aculleon/rpm_TSAL/3D/TBA_1-1219HI.stp

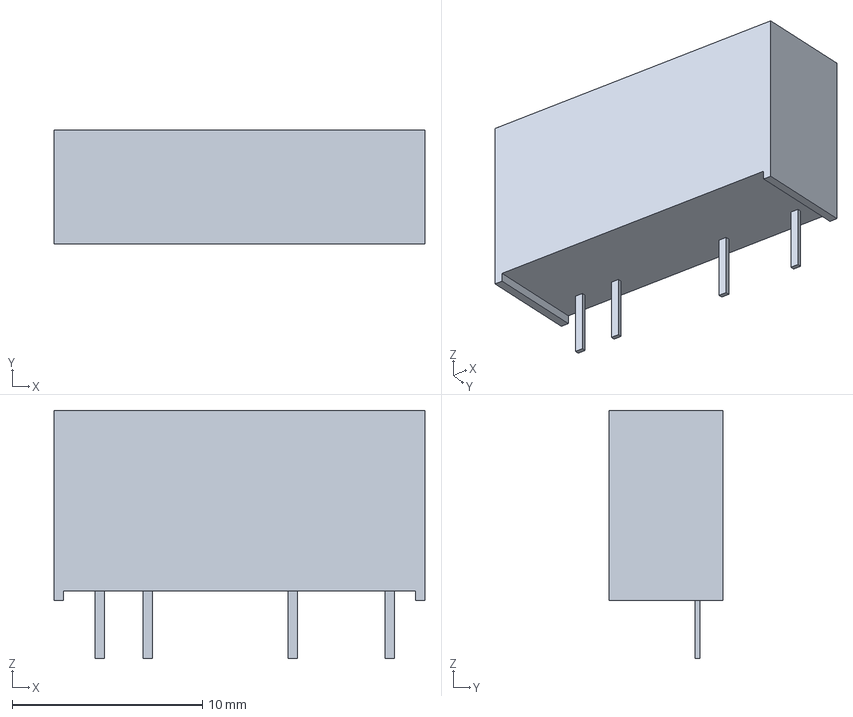
[picture p1: CAD file, 2024-07-24]
3D/TBA_1-1219HI.stp
19.5 x 6.00 x 13.1 mm
