aculleon/rpm_TSAL/rpm_TSAL.step

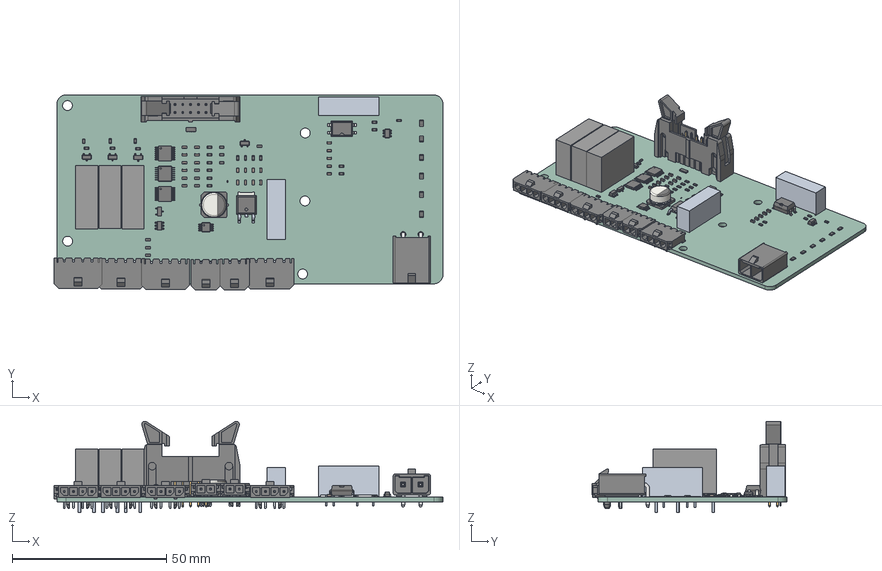
[picture p2: CAD file, 2024-07-24]
rpm_TSAL.step
126.2 x 63.3 x 29.7 mm
R_0603_1608Metric x 31
C_0603_1608Metric x 22
R_0805_2012Metric x 6
SOT_23_6 x 2
TSSOP_14_44x5mm_P065mm x 3
6620xx11022 x 4
SOT-23-3 x 5
6620xx11024 x 2
TBA1HI-SINGLE x 2
6120xx22021
CQ assembly x 2
Nexperia_HUSON-16_USON-16-1EP_1.35x3.3mm_P0.4mm_EP0.4x2.8mm
SMDIP_4_W953mm
6570xx130101
TSSOP_8_3x3mm_P065mm
CP_Elec_8x54
ASSEMBLY x 3
rpm_TSAL_PCB
