aculleon/rpm_TSAL/rpm_TSAL_RED/3D/AZ9371-1A-12D.stp

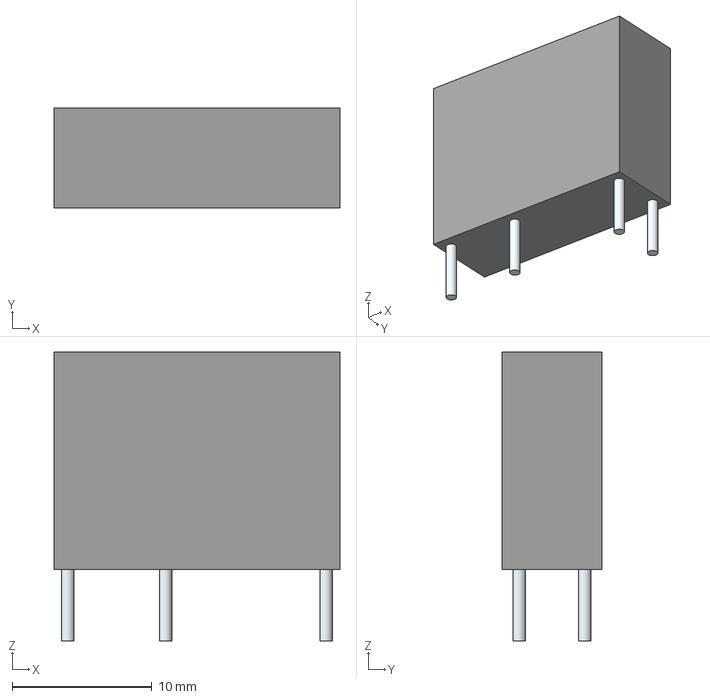
[picture p3: CAD file, 2024-07-11]
rpm_TSAL_RED/3D/AZ9371-1A-12D.stp
20.5 x 7.20 x 20.7 mm
Leads x 4
