aculleon/rpm_TSAL/rpm_TSAL_RED/3D/STP_MPC5_657002130101 (rev1).stp

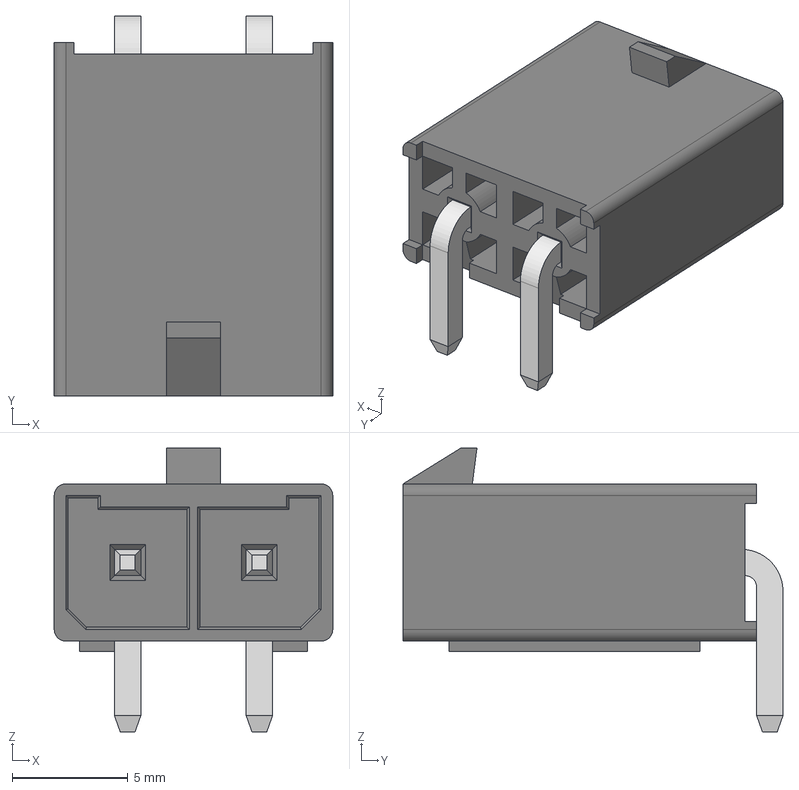
[picture p4: CAD file, 2024-07-11]
rpm_TSAL_RED/3D/STP_MPC5_657002130101 (rev1).stp
12.1 x 16.4 x 12.3 mm
6570xx130101_Pin x 2
