aculleon/rpm_TSAL/rpm_TSAL_RED/3D/66200411022 (rev1).stp

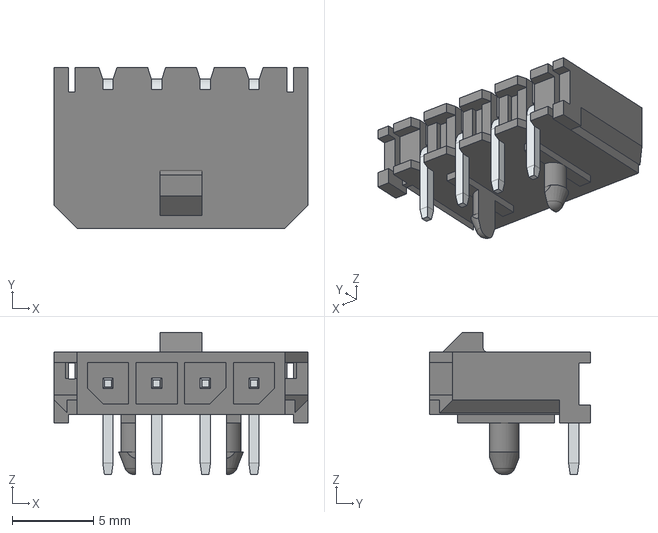
[picture p5: CAD file, 2024-07-11]
rpm_TSAL_RED/3D/66200411022 (rev1).stp
15.7 x 9.90 x 8.76 mm
6620xx11022_PIN x 4
