aculleon/rpm_TSAL/3D/66200421022 (rev1).stp

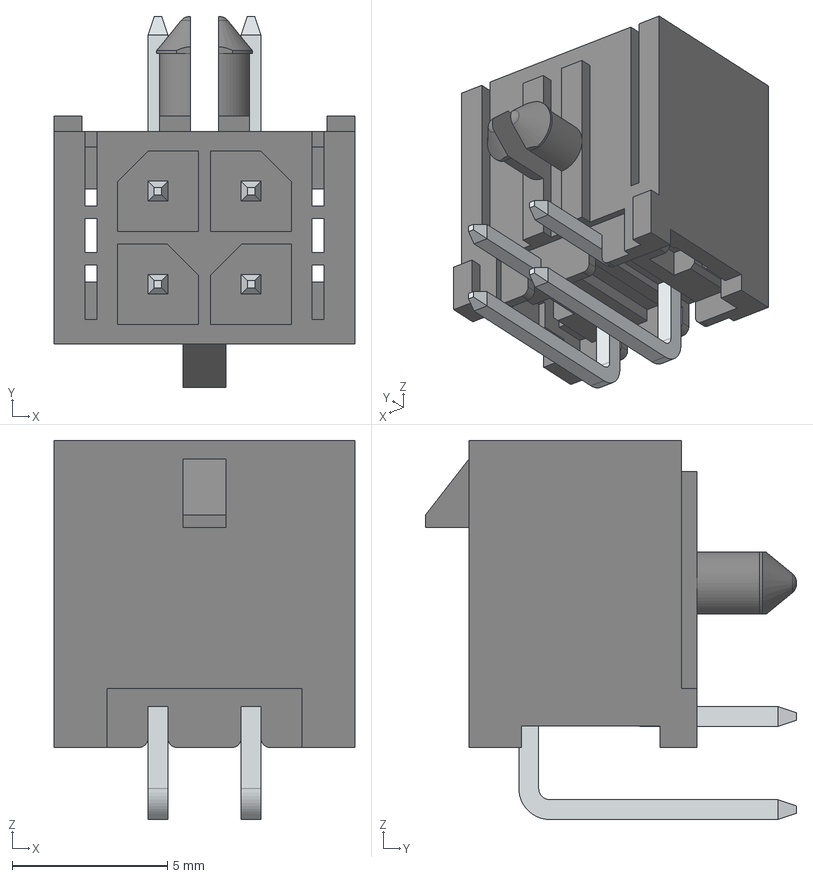
[picture p6: CAD file, 2024-07-24]
3D/66200421022 (rev1).stp
9.70 x 12.0 x 12.2 mm
6620xx21022_PIN_COURTE x 2
6620xx21022_PIN_LONGUE x 2
