aculleon/rpm_TSAL/3D/61201022021 (rev1).stp

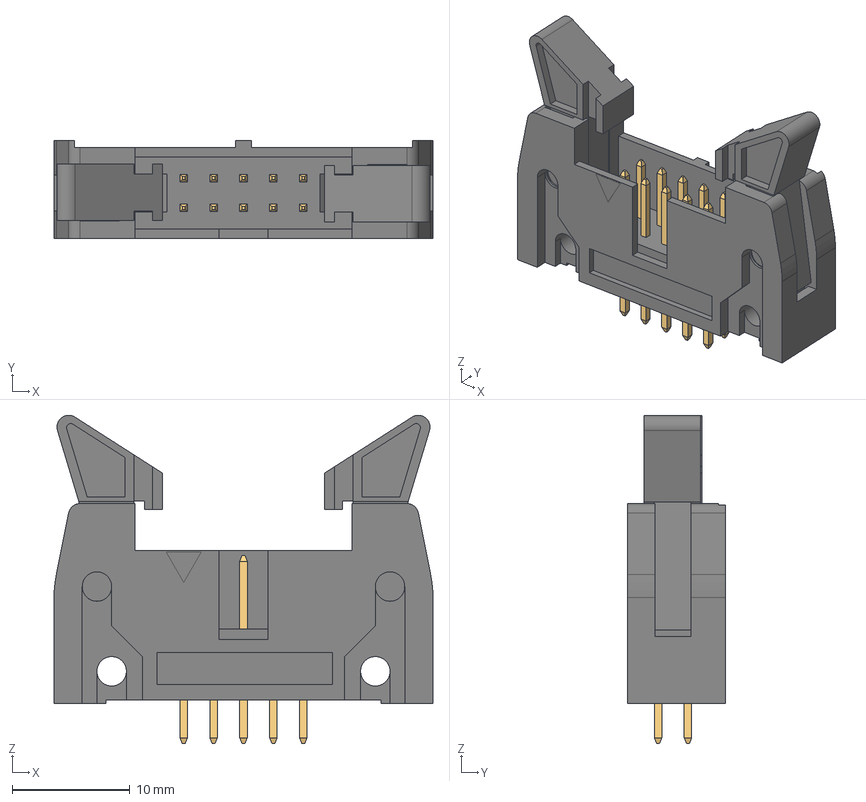
[picture p7: CAD file, 2024-07-24]
3D/61201022021 (rev1).stp
32.2 x 8.31 x 27.9 mm
6120xx22x21_LEVIER_COURT x 2
6120xx21621_PIN x 10
