aculleon/rpm_TSAL/rpm_TSAL_RED/3D/66201421022 (rev1).stp

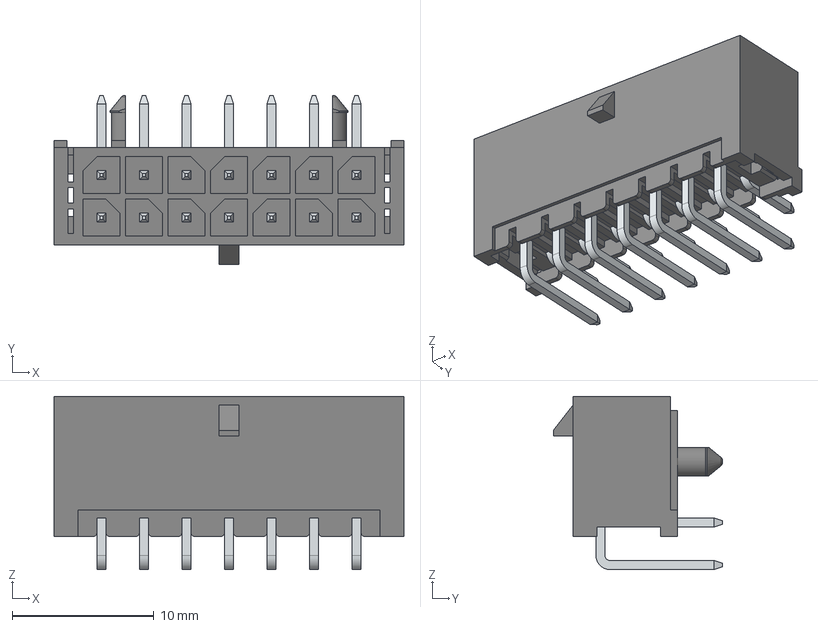
[picture p8: CAD file, 2024-07-11]
rpm_TSAL_RED/3D/66201421022 (rev1).stp
24.7 x 12.0 x 12.2 mm
6620xx21022_PIN_COURTE x 7
6620xx21022_PIN_LONGUE x 7
