aculleon/rpm_TSAL/rpm_TSAL_RED/3D/66200211024_STP (rev1).stp

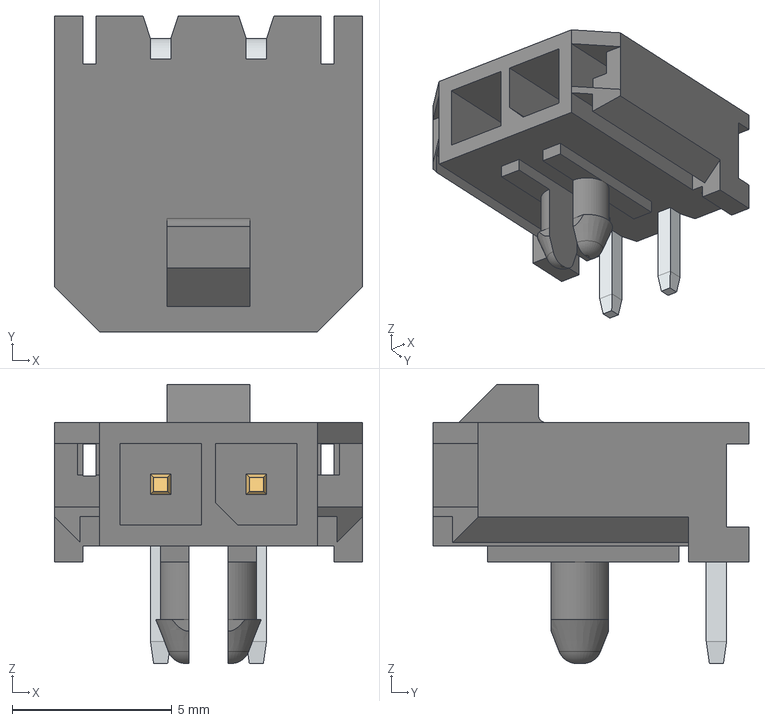
[picture p9: CAD file, 2024-07-11]
rpm_TSAL_RED/3D/66200211024_STP (rev1).stp
9.65 x 9.90 x 8.76 mm
6620xx11024_PIN x 2
