aculleon/rpm_TSAL/rpm_TSAL_RED/3D/66200311022 (rev1).stp

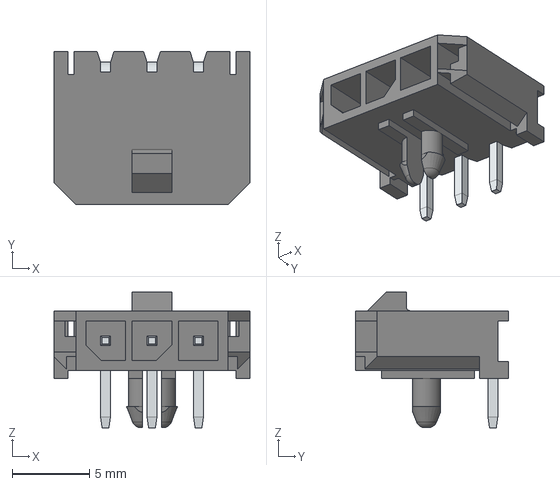
[picture p10: CAD file, 2024-07-11]
rpm_TSAL_RED/3D/66200311022 (rev1).stp
12.7 x 9.90 x 8.76 mm
6620xx11022_PIN x 3
