aculleon/rpm_TSAL/rpm_TSAL.pdf

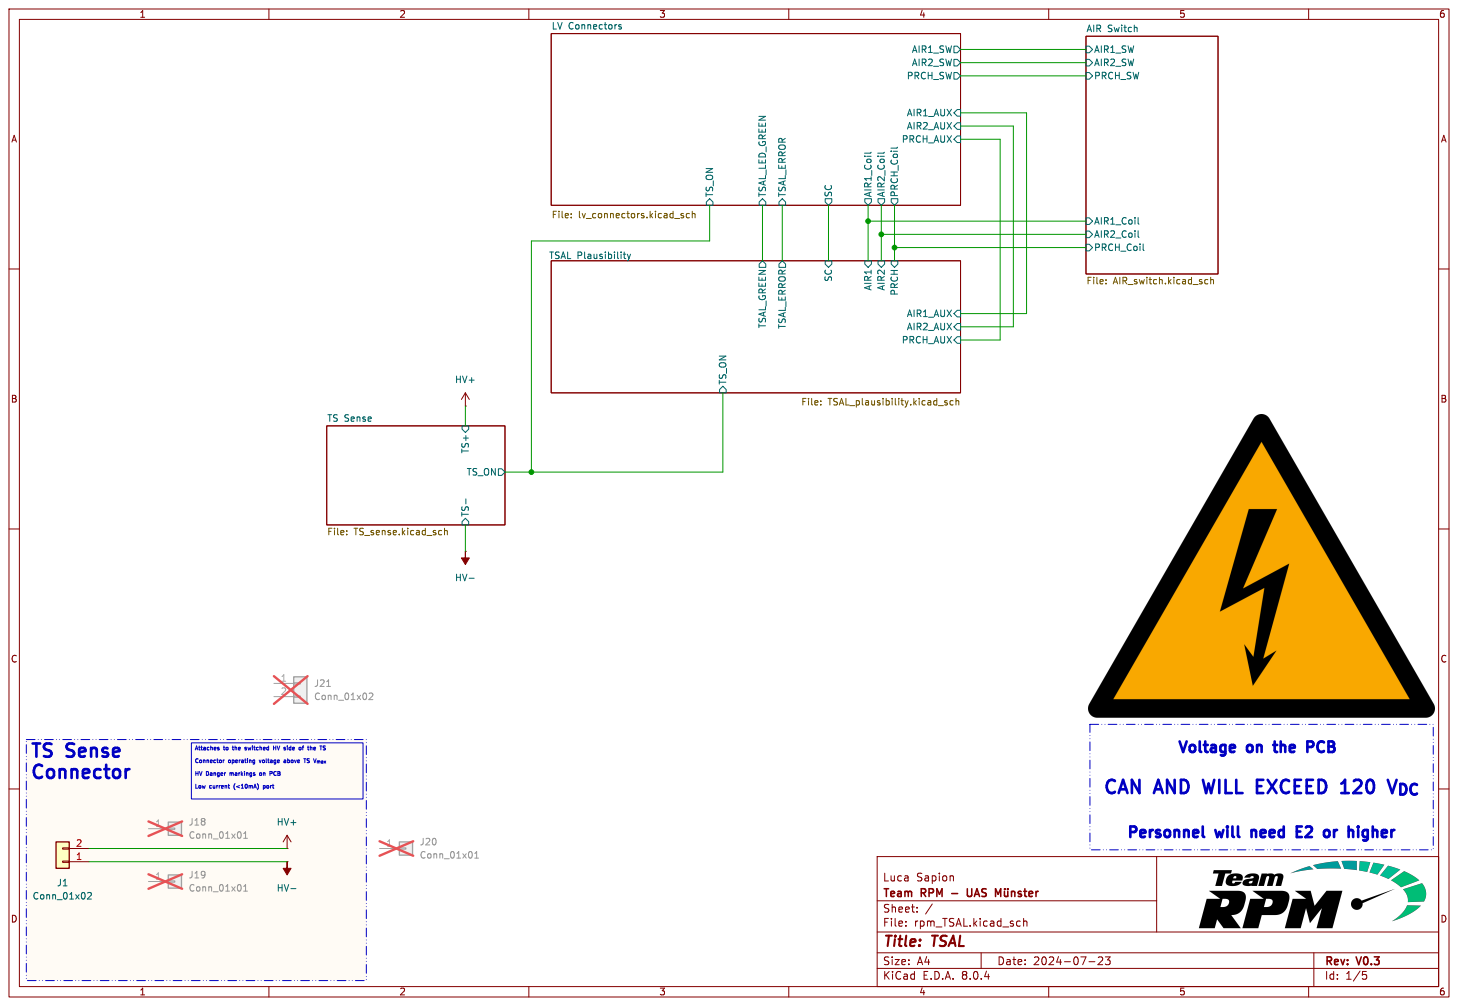
[picture p11: page 1]

LV Connectors File: lv_connectors.kicad_sch TS_ON TS+ TS- TS Sense File: TS_sense.kicad_sch

AIR1_Coil AIR Switch File: AIR_switch.kicad_sch SC

HV+ HV- TS Sense

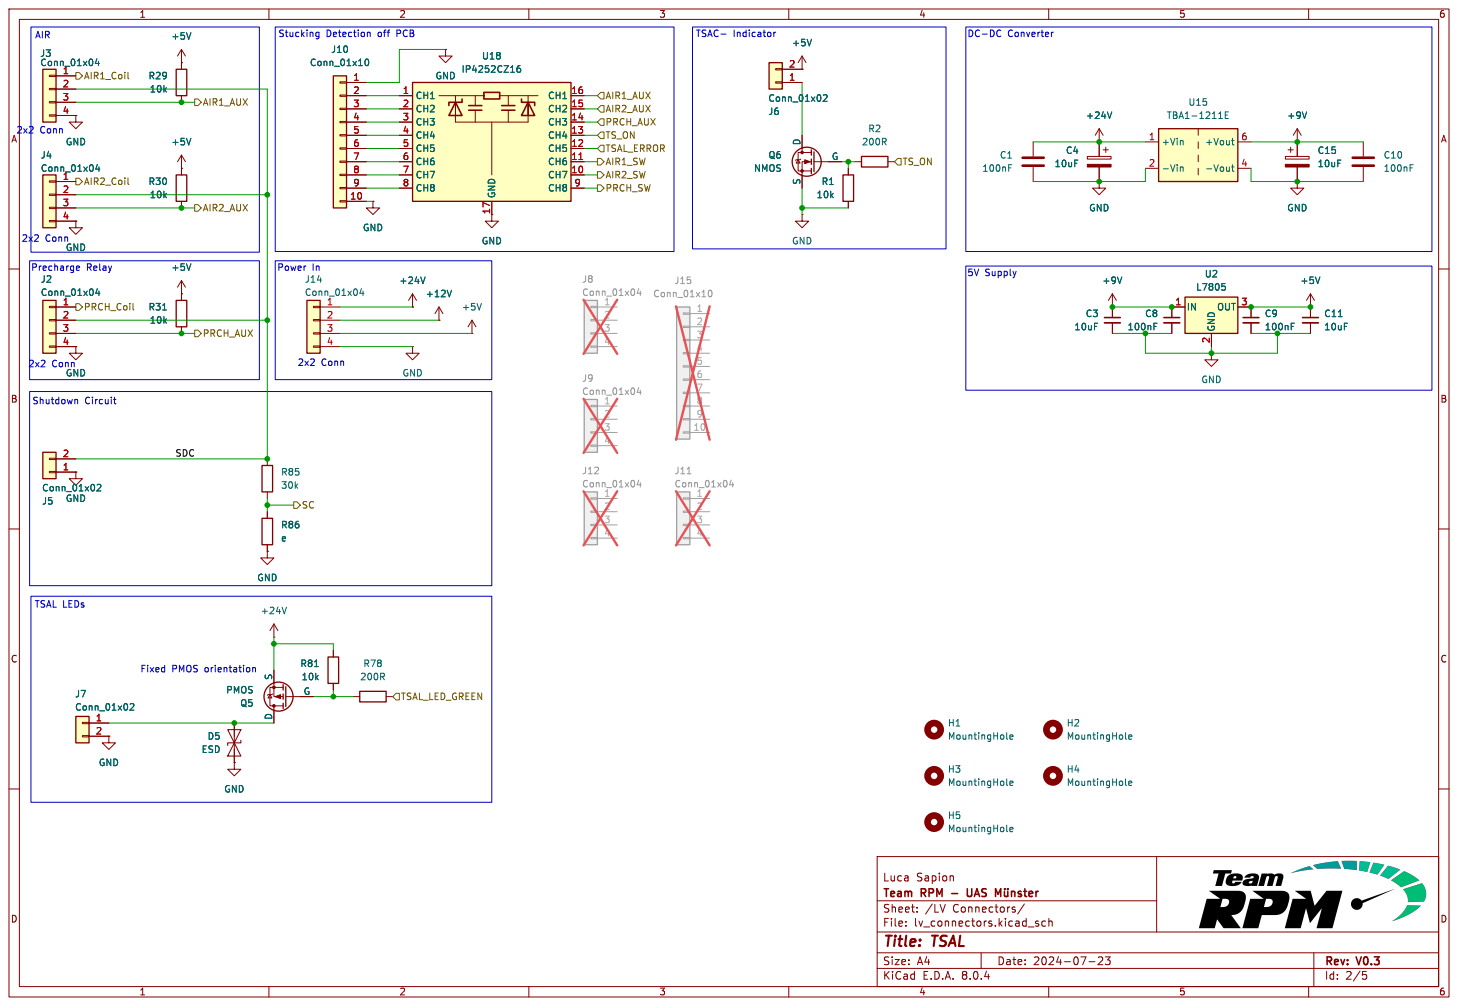
[picture p12: page 2]

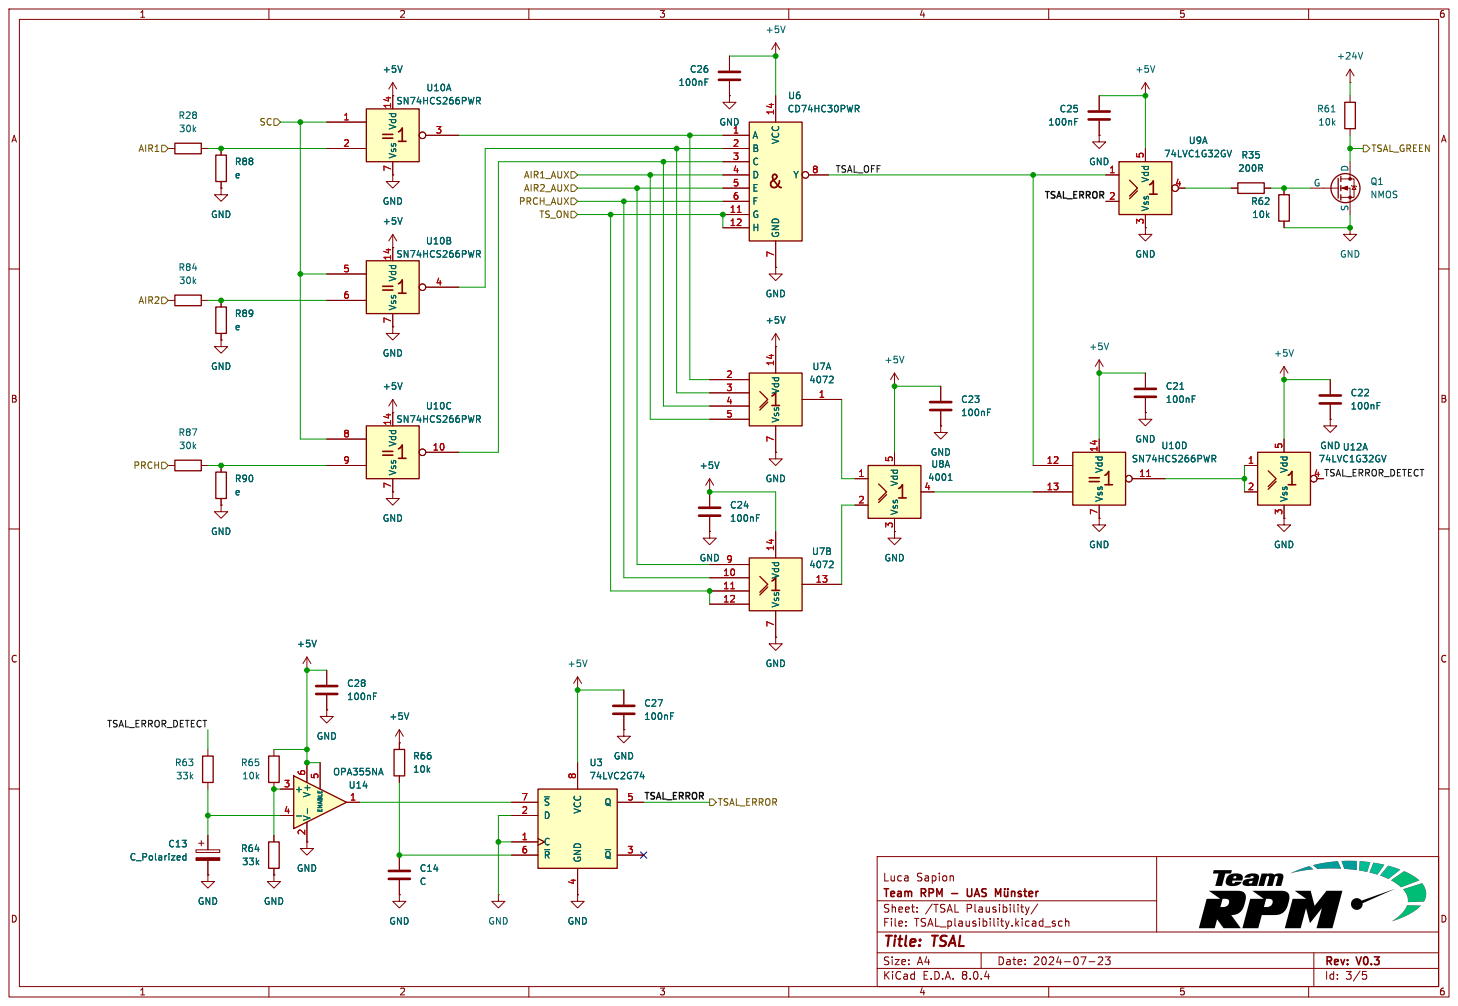
[picture p13: page 3]

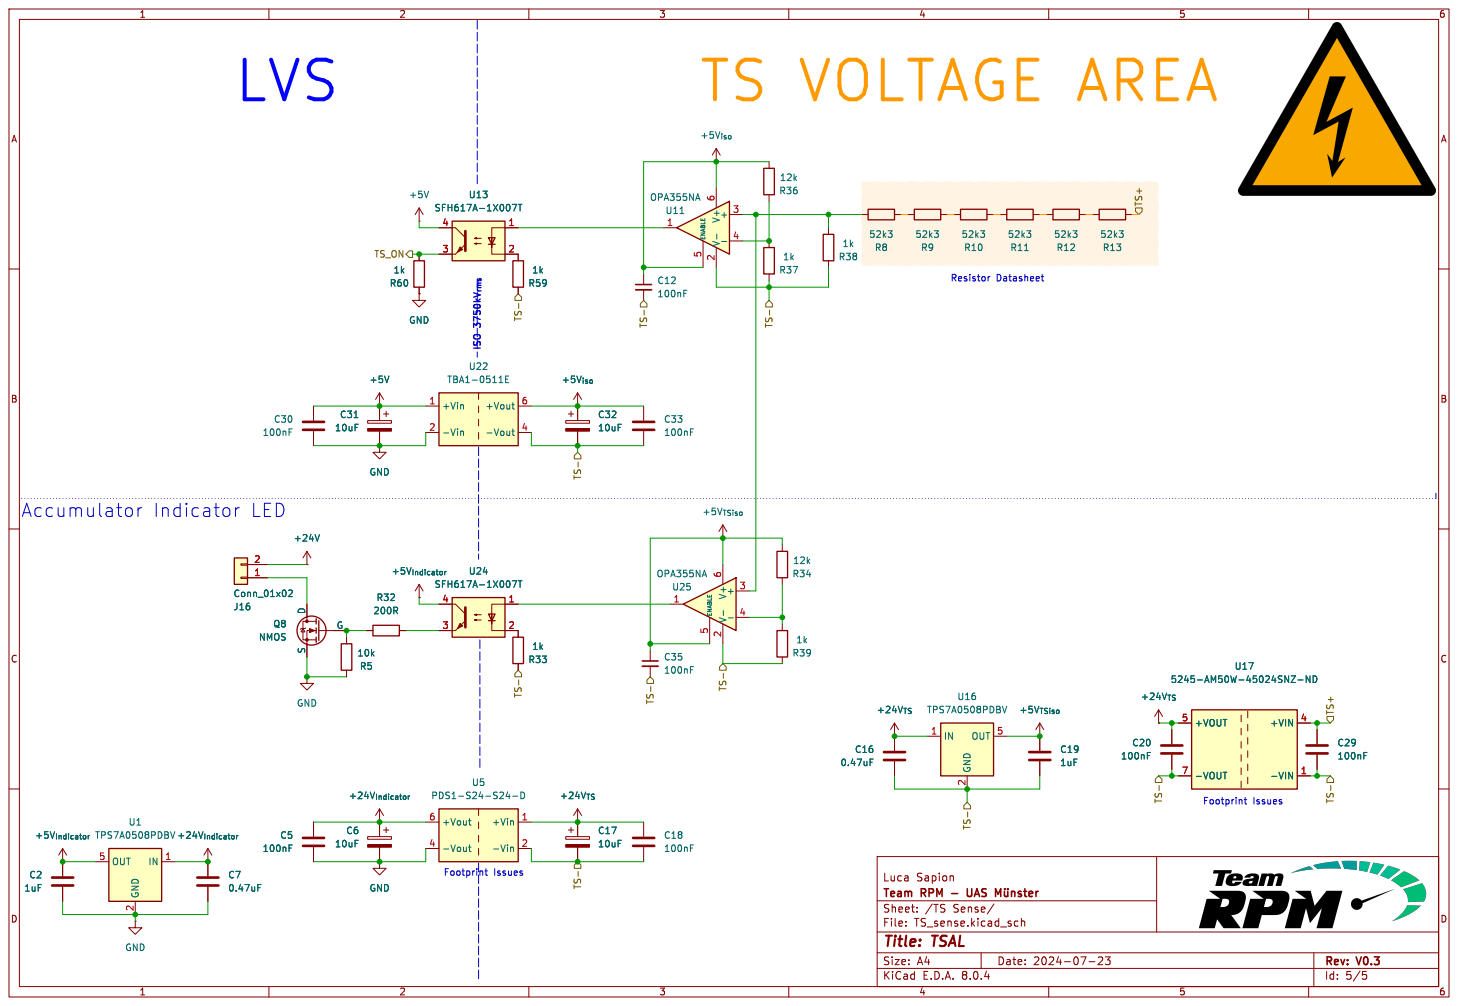
[picture p14: page 4]

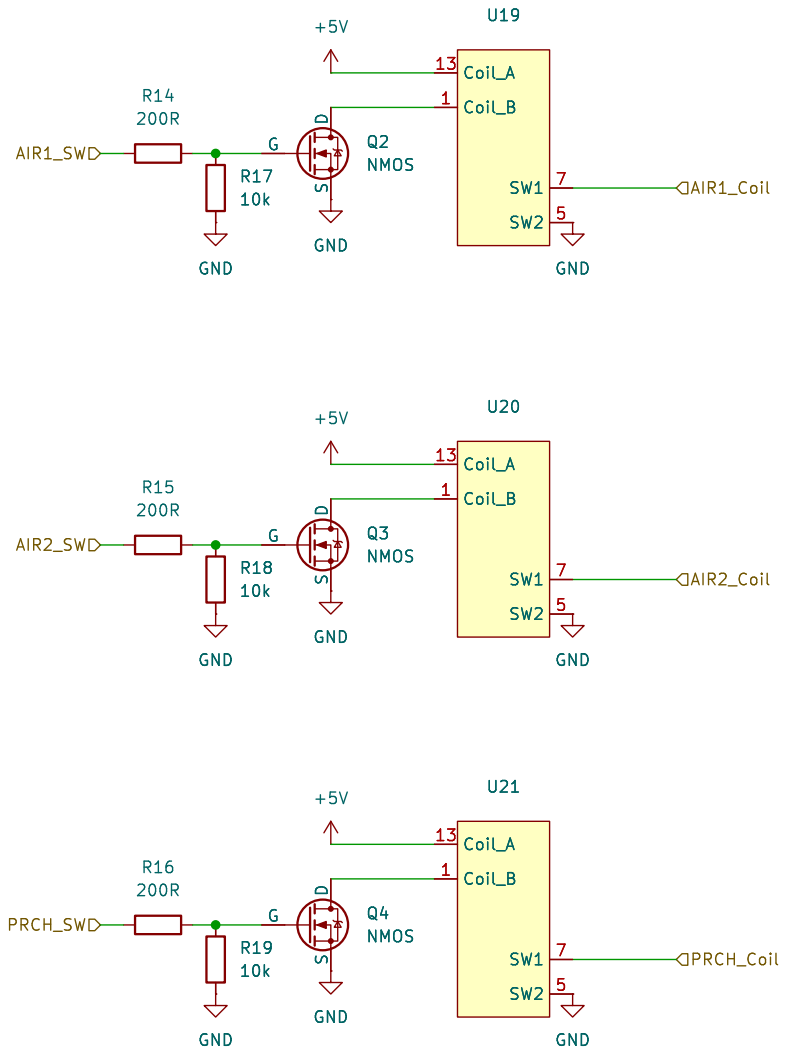
[picture p15: page 5]
