aculleon/rpm_TSAL/TSAL_ALL_V2.0.pdf

## closed open

## Coil+

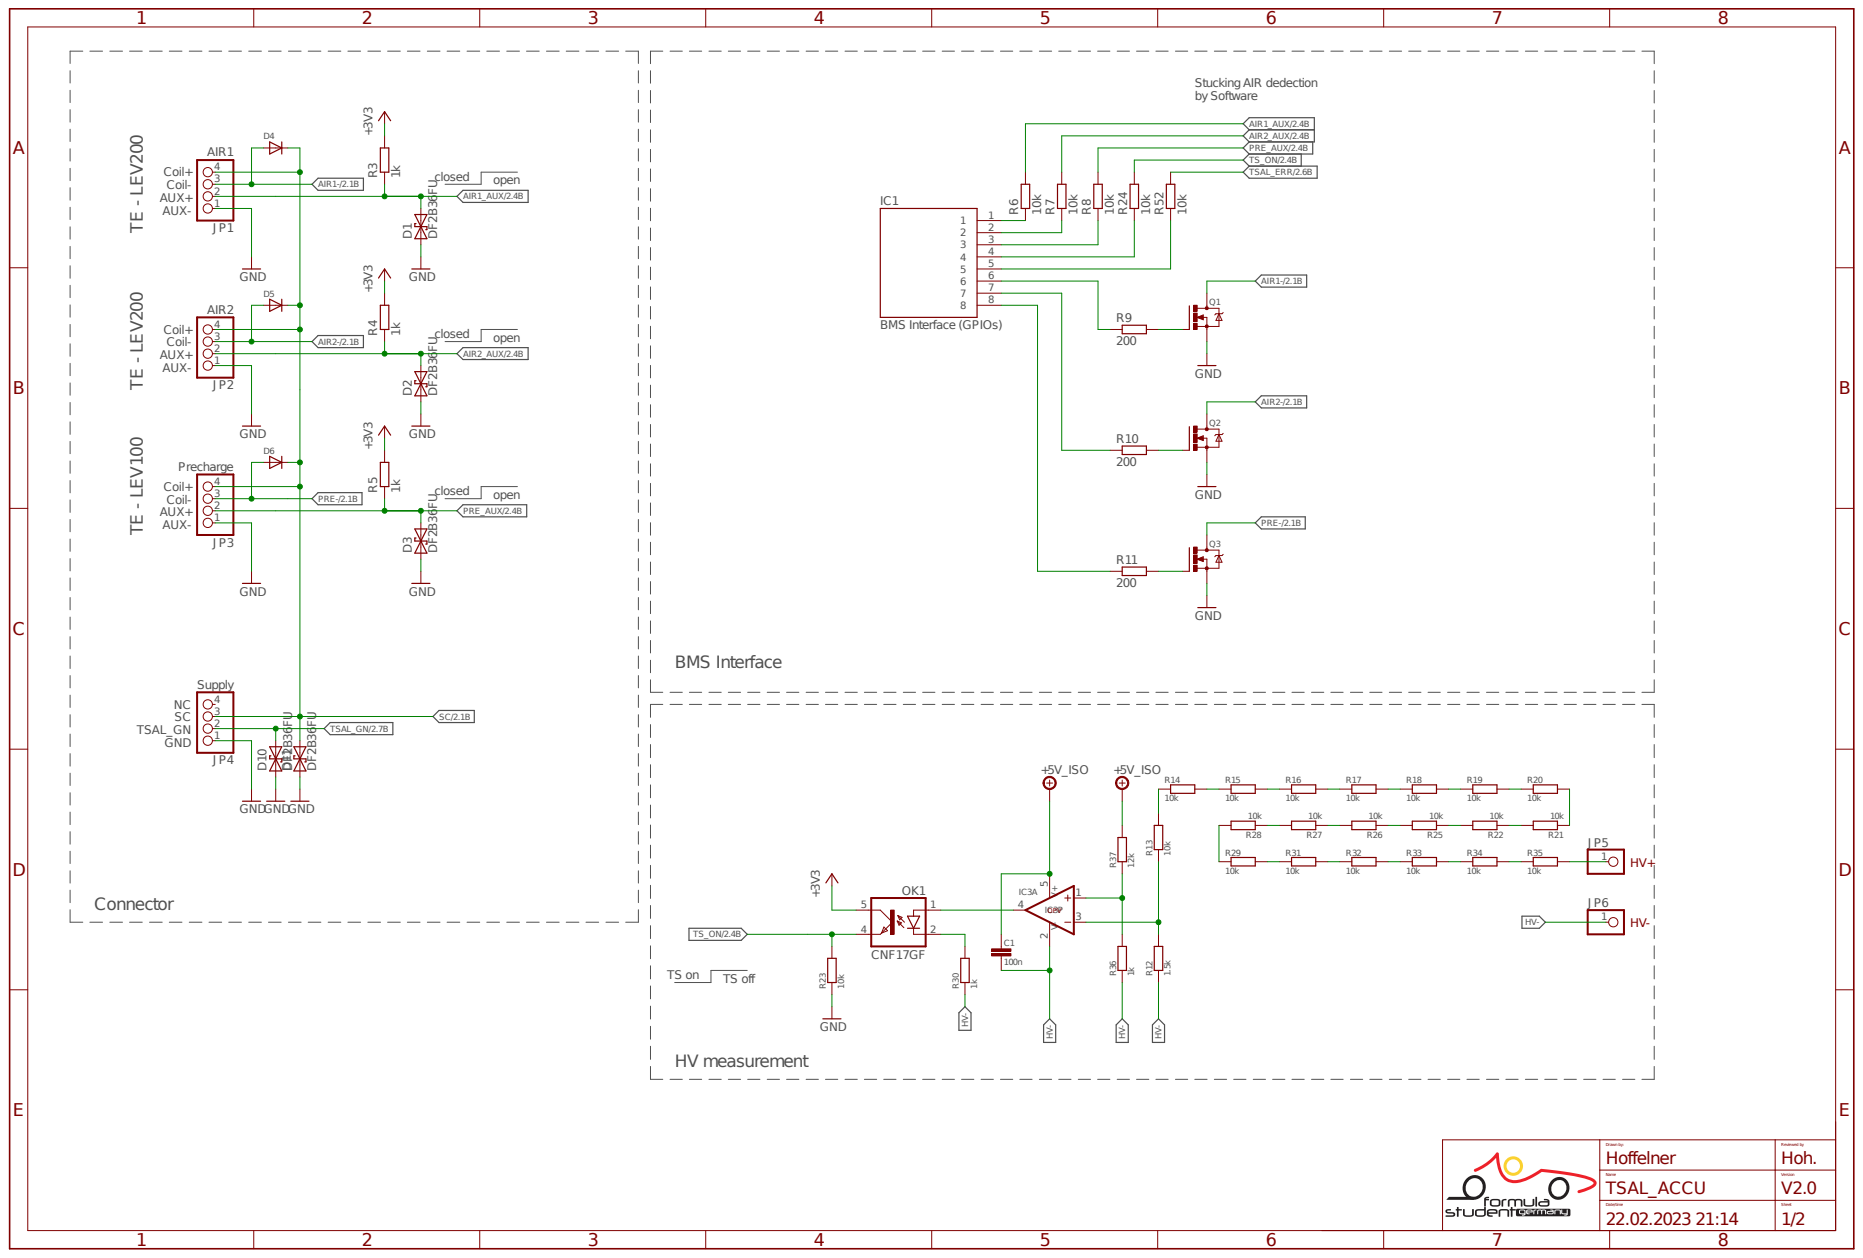
[picture p16: page 1]

Drawn by: Hoffelner | Reviewed by Hoh.
Name TSAL_ACCU | Version V2.0

Date/time 22.02.2023 21:14 | Sheet 1/2

# AIR State Detection

# Output Driver

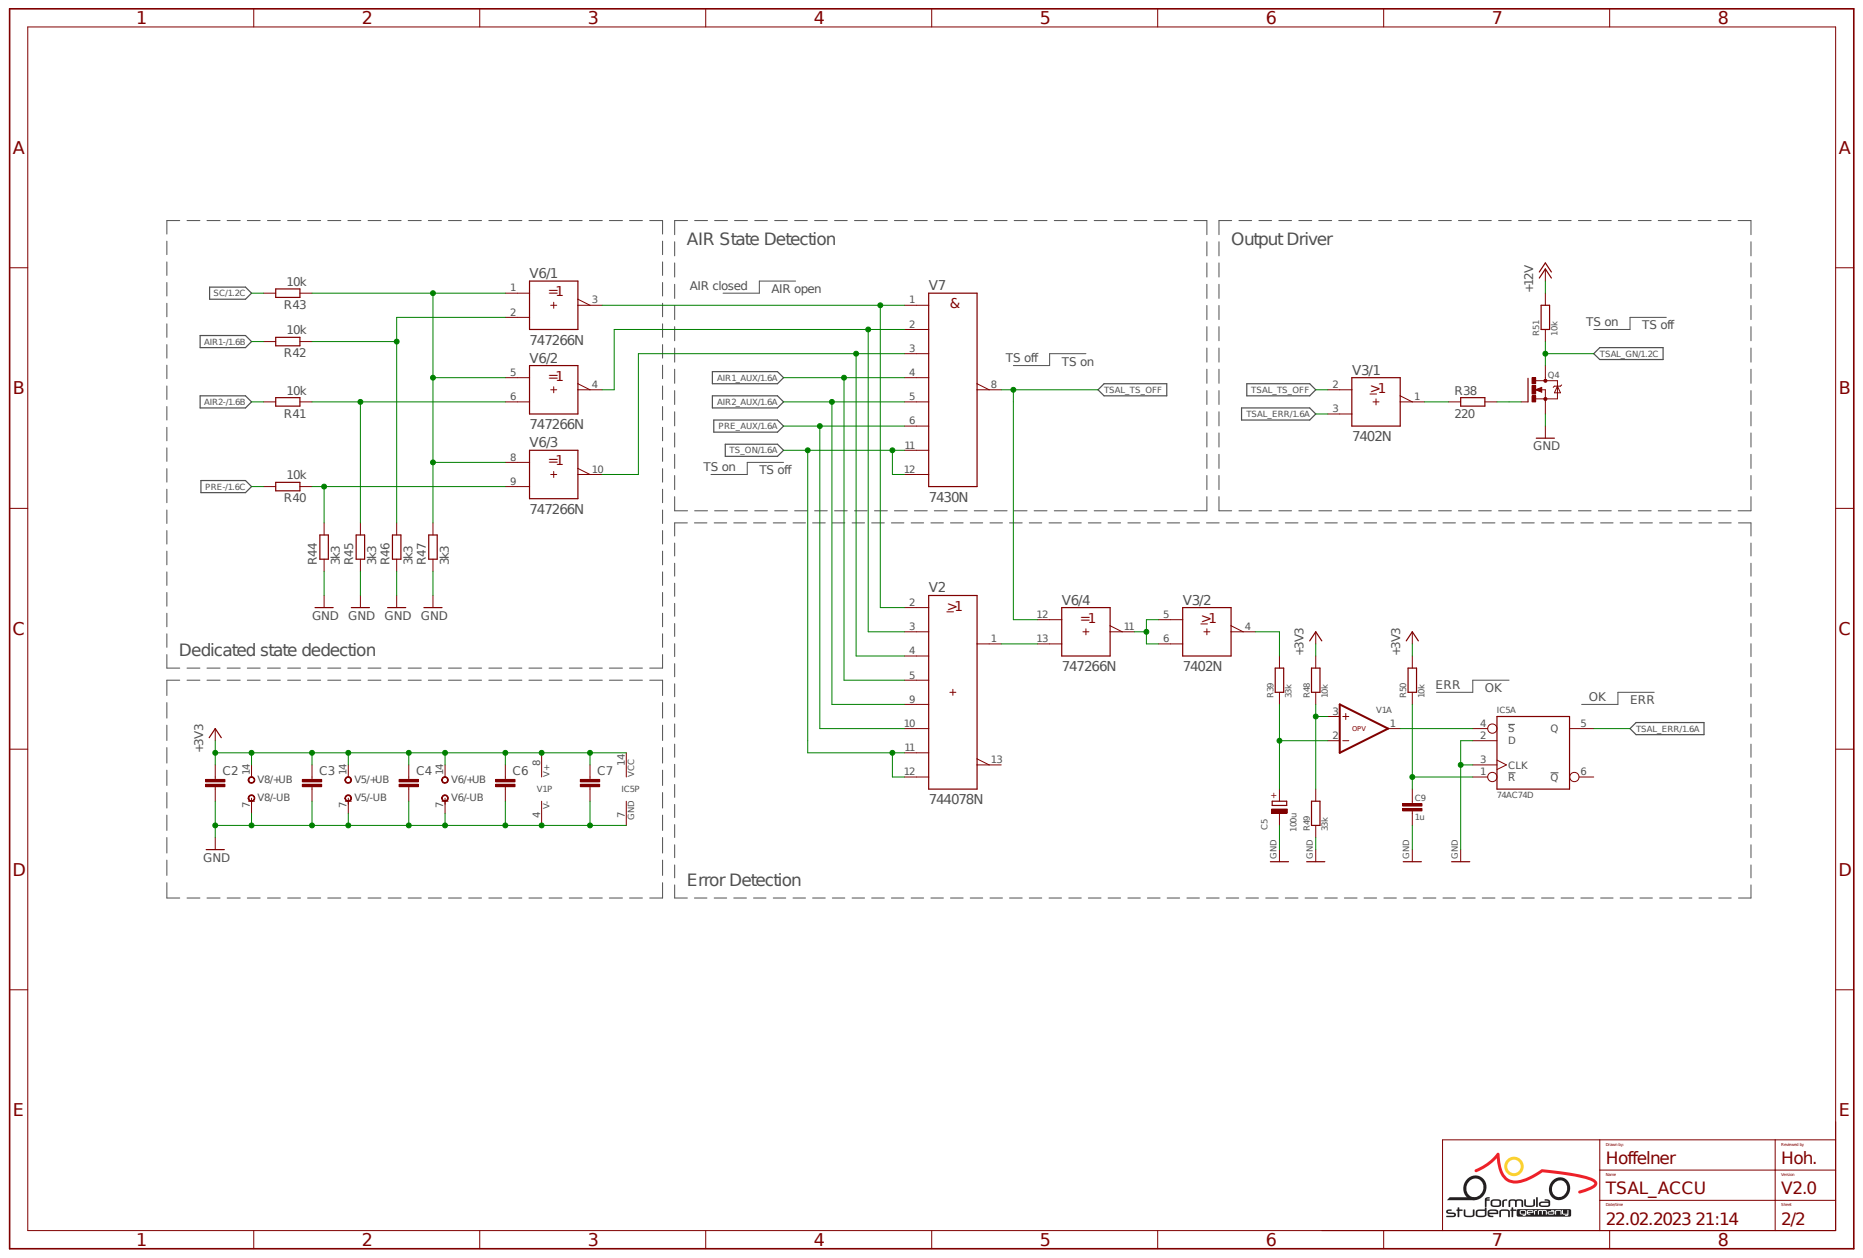
[picture p17: page 2]

GND GND

Drawn by: Hoffelner | Reviewed by Hoh.
Name TSAL_ACCU | Version V2.0

100n1k

J P1

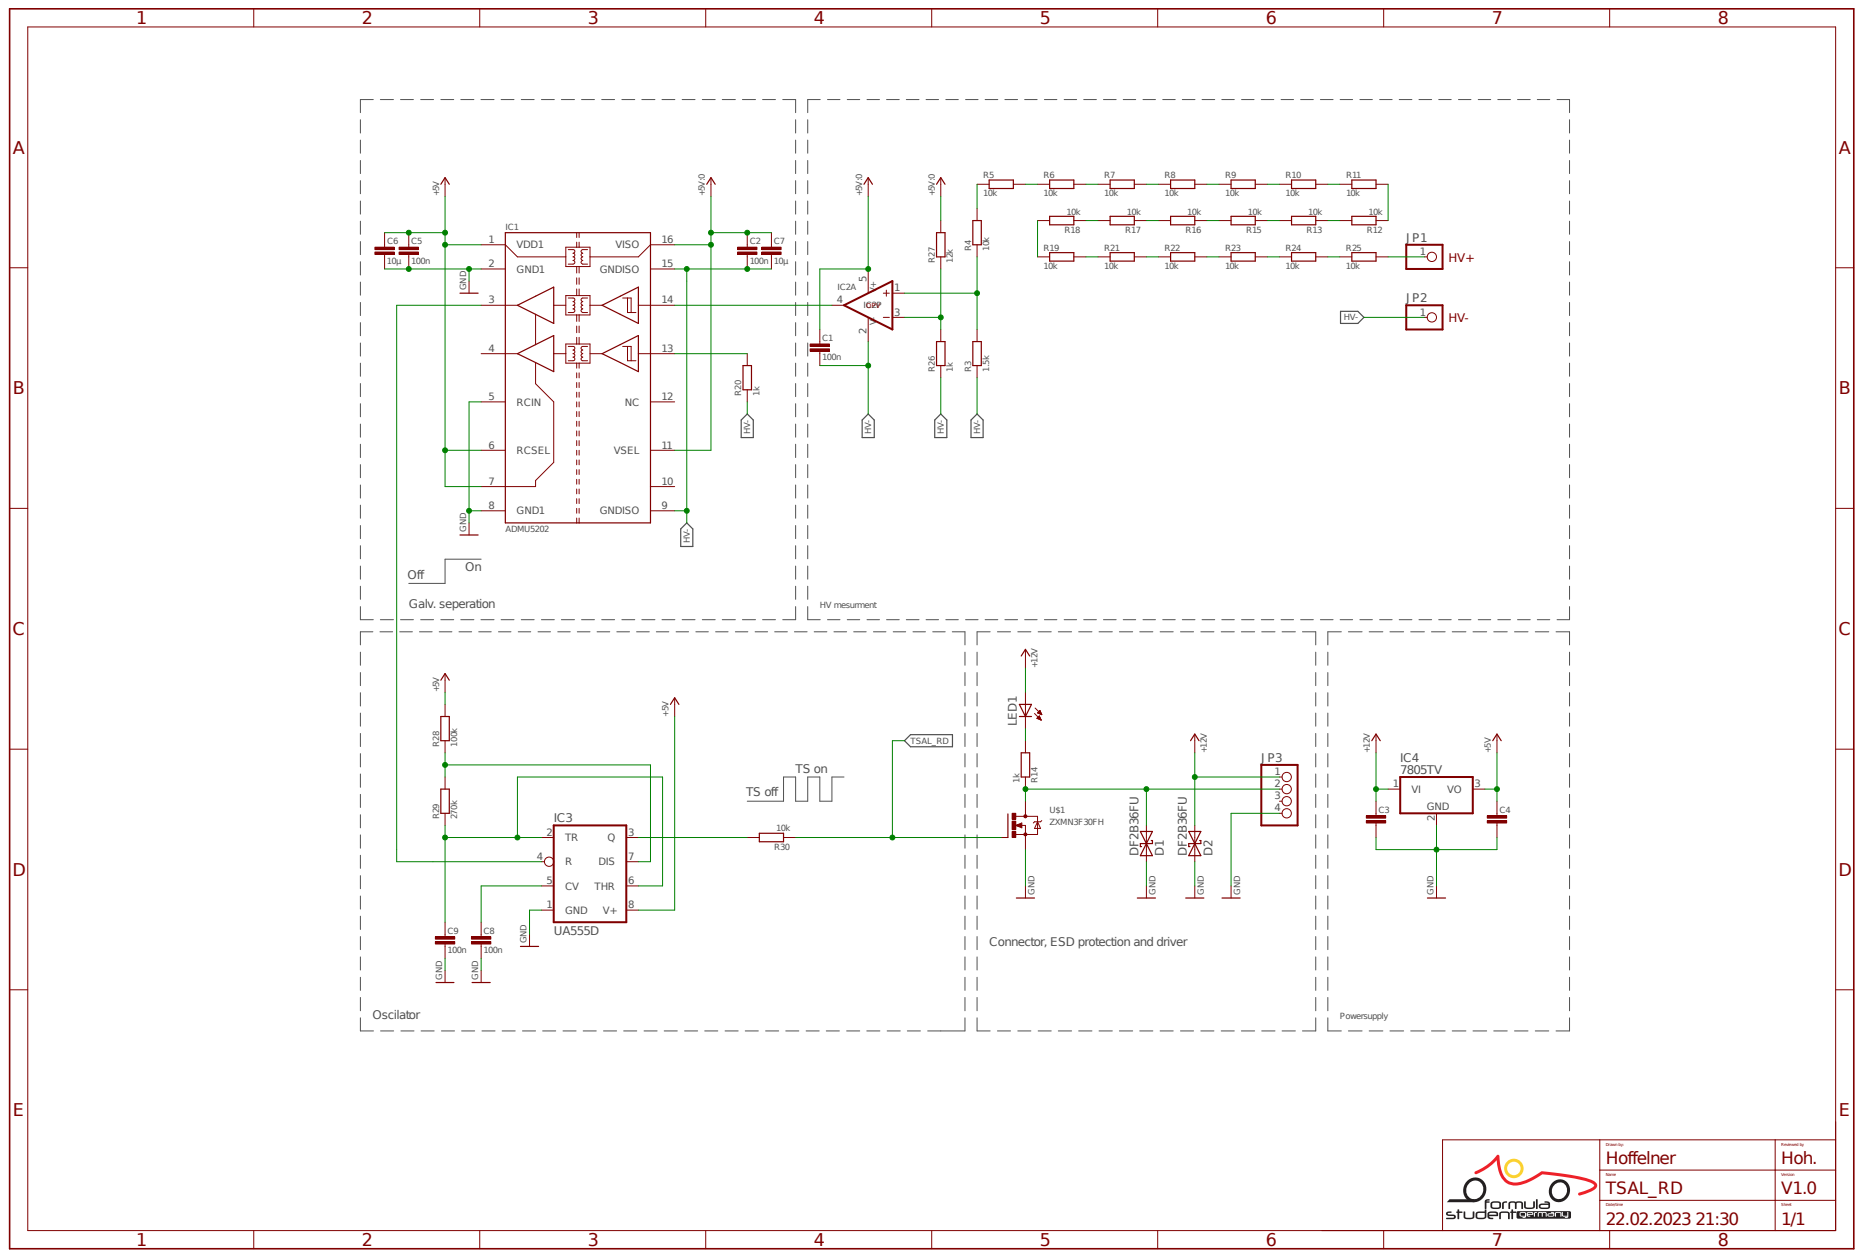
[picture p18: page 3]

Connector, ESD protection and driver

Drawn by: Hoffelner | Reviewed by Hoh.
Name TSAL_RD | Version V1.0

A

A

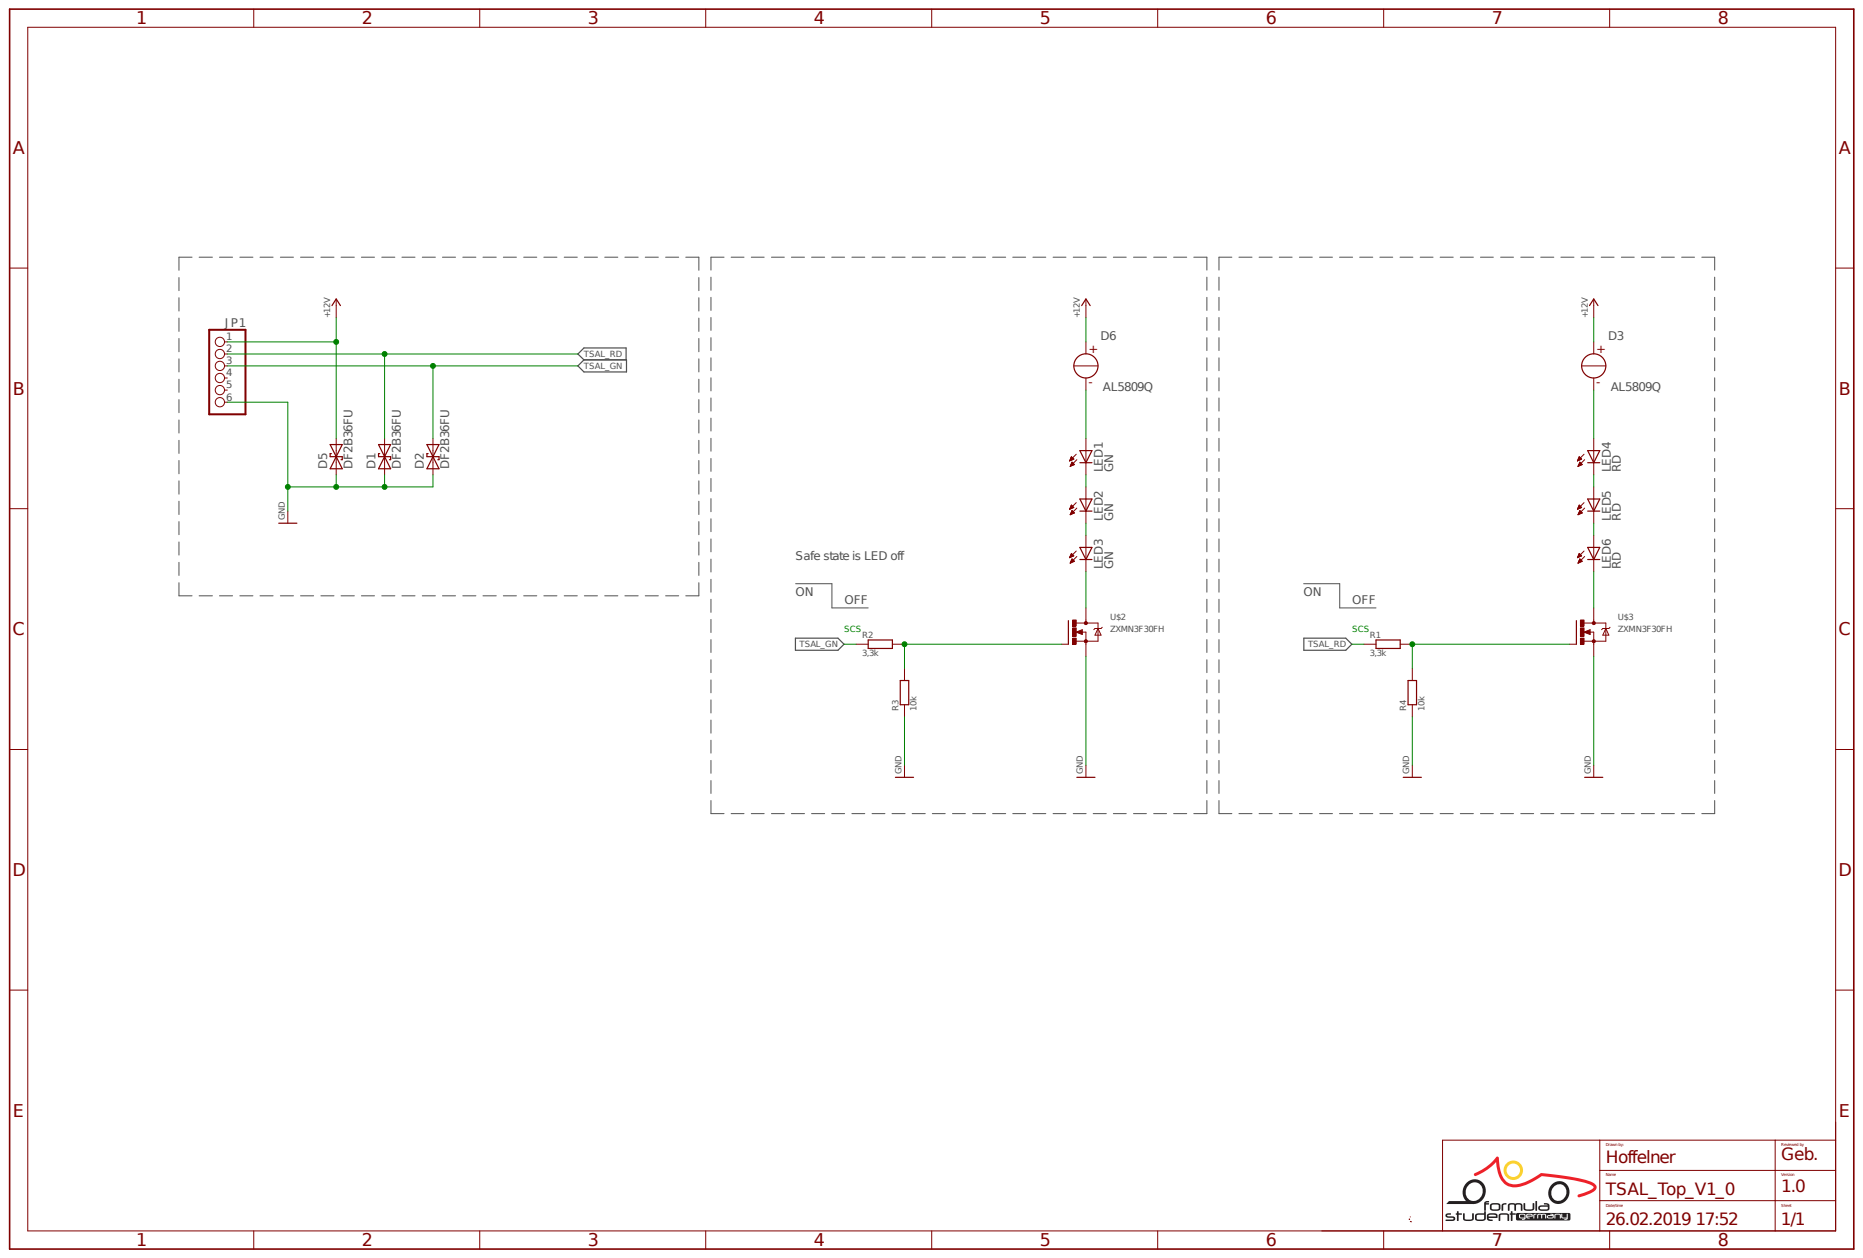
[picture p19: page 4]

Safe state is LED off

Drawn by: Hoffelner | Reviewed by Geb.
Name TSAL_Top_V1_0 | Version 1.0
Date/time 26.02.2019 17:52 | Sheet 1/1
