aculleon/rpm_TSAL/rpm_TSAL_RED/rpm_TSAL_RED.pdf

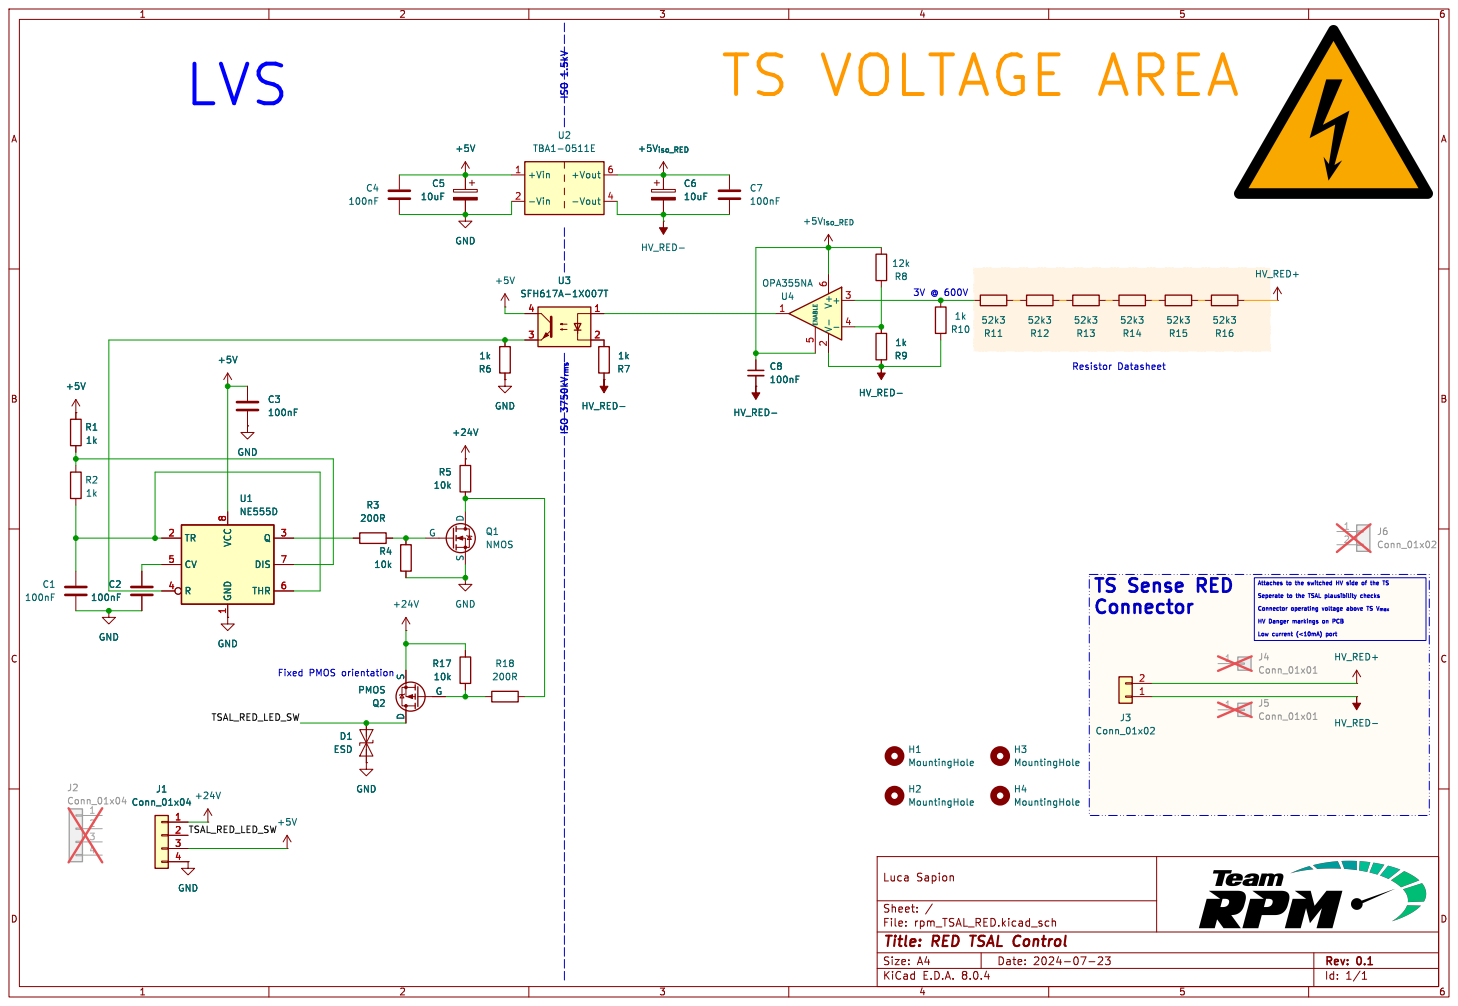
[picture p20: page 1]

Resistor Datasheet (https://www.mouser.de/datasheet/2/447/PYu_RT_1_to_0_01_RoHS_L_15-3461507.pdf) TS VOLTAGE AREA

Id: 1/1 Title: RED TSAL Control File: rpm_TSAL_RED.kicad_sch Sheet: / Luca Sapion Internal
