aculleon/rpm_TSAL/rpm_TSAL.kicad_pcb

## KiCad design rpm_TSAL.kicad_pcb (2024-08-01)

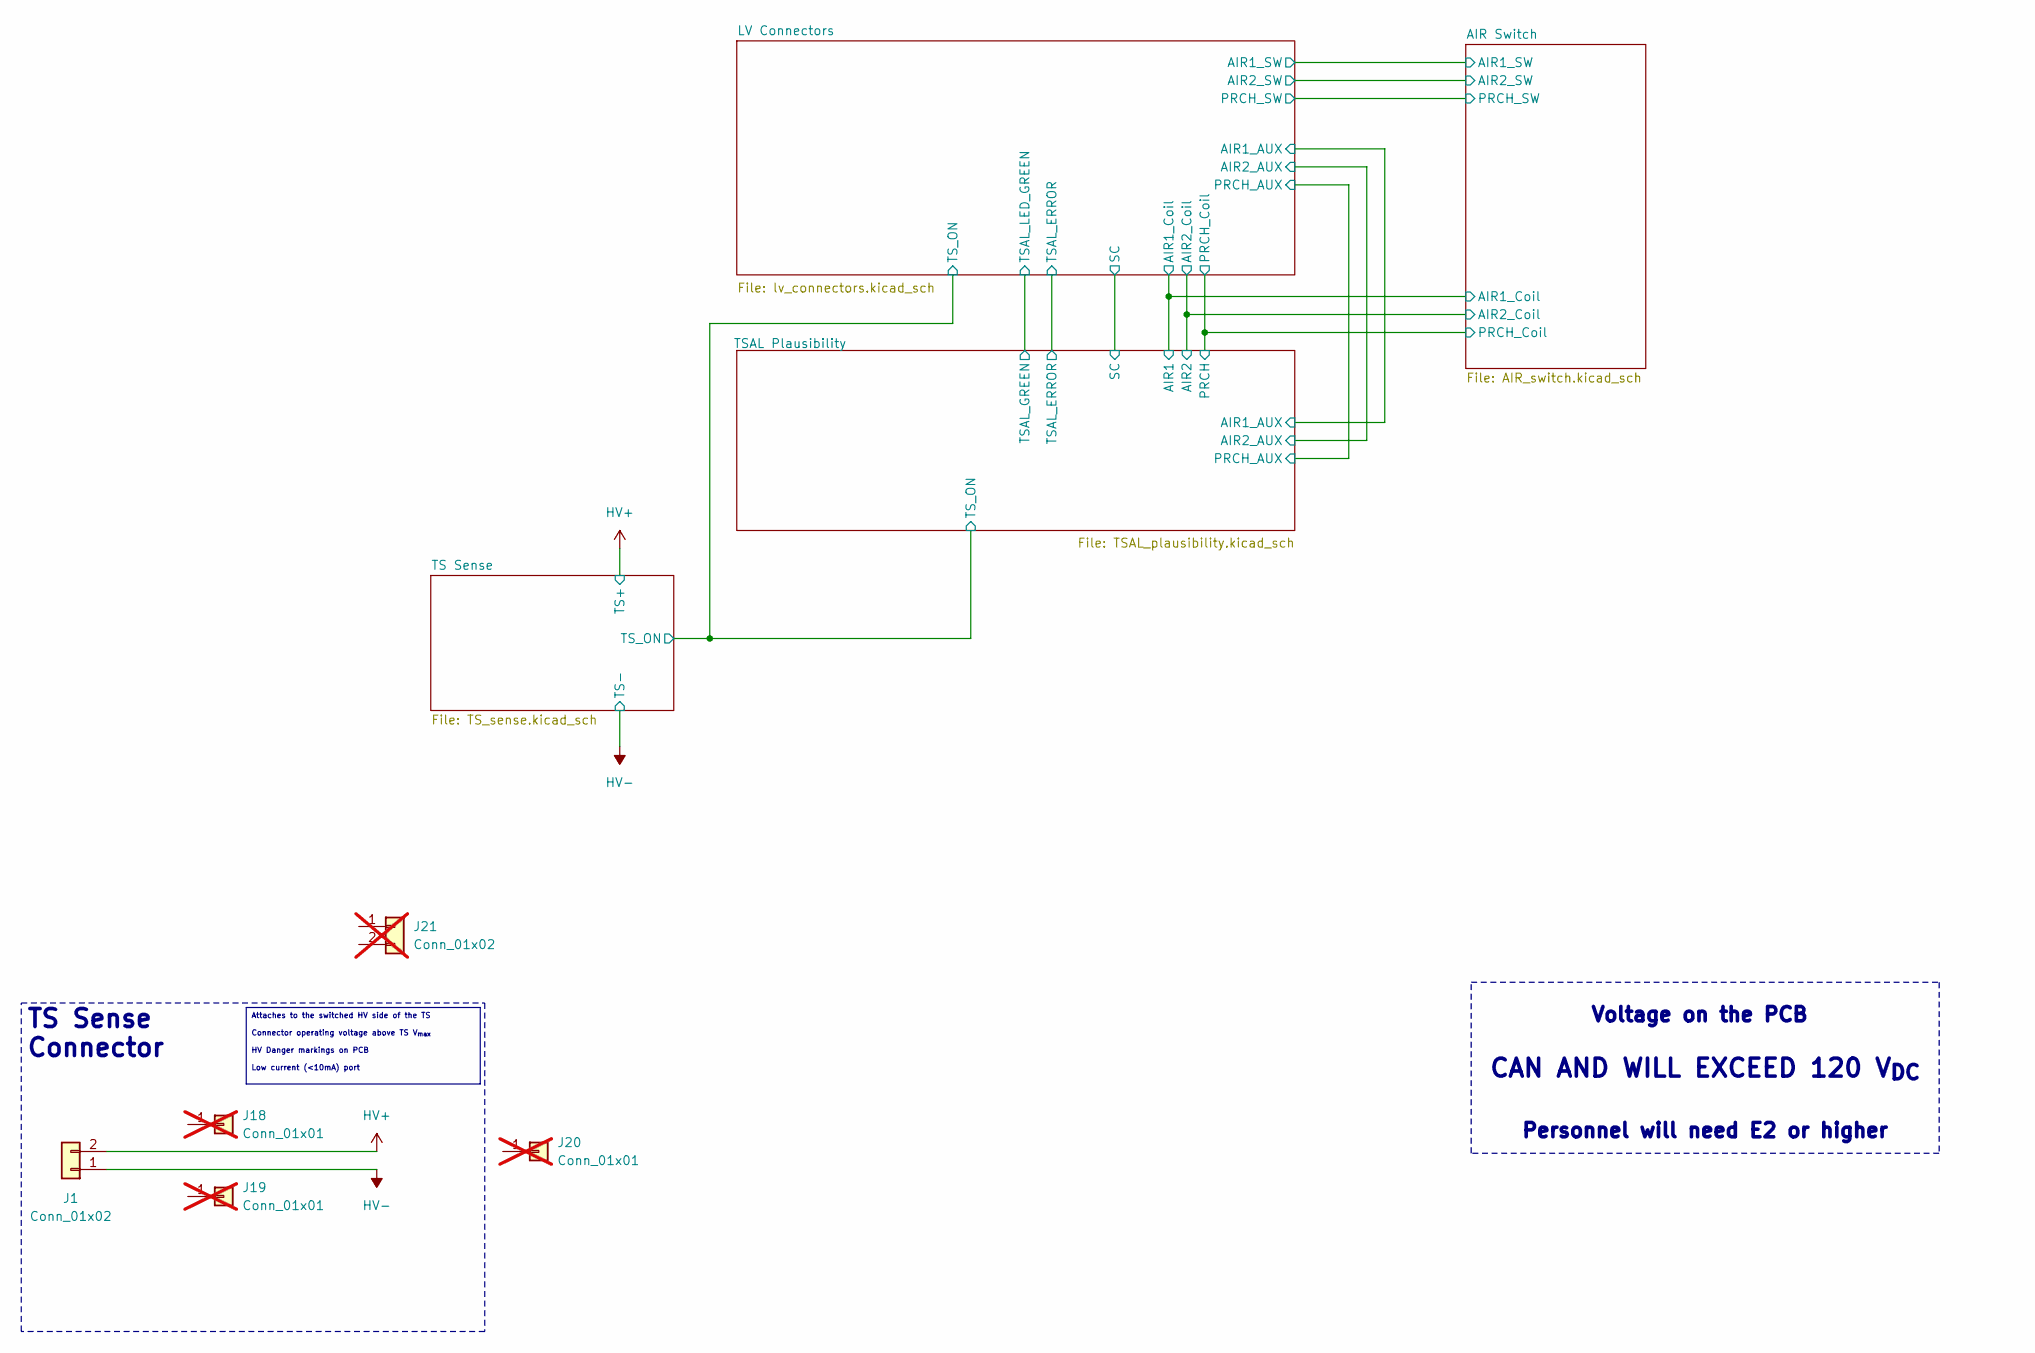
[picture p21: schematic rpm_TSAL.kicad_sch, TSAL]

Parts:
J1: Conn_01x02; 657002130101; Mouser 710-657002130101
J18, J19, J20: Conn_01x01; Mouser 710-65730513722DEC; not fitted
J21: Conn_01x02; Mouser 710-657002150201; not fitted

Connections:
HV+: J1.2; also elsewhere on the board
HV-: J1.1; also elsewhere on the board

Notes on the sheet:
_{Voltage on the PCB } CAN AND WILL EXCEED 120 V_{DC} _{Personnel will need E2 or higher}
Attaches to the switched HV side of the TS Connector operating voltage above TS V_{max} HV Danger markings on PCB Low current (<10mA) port
TS Sense Connector

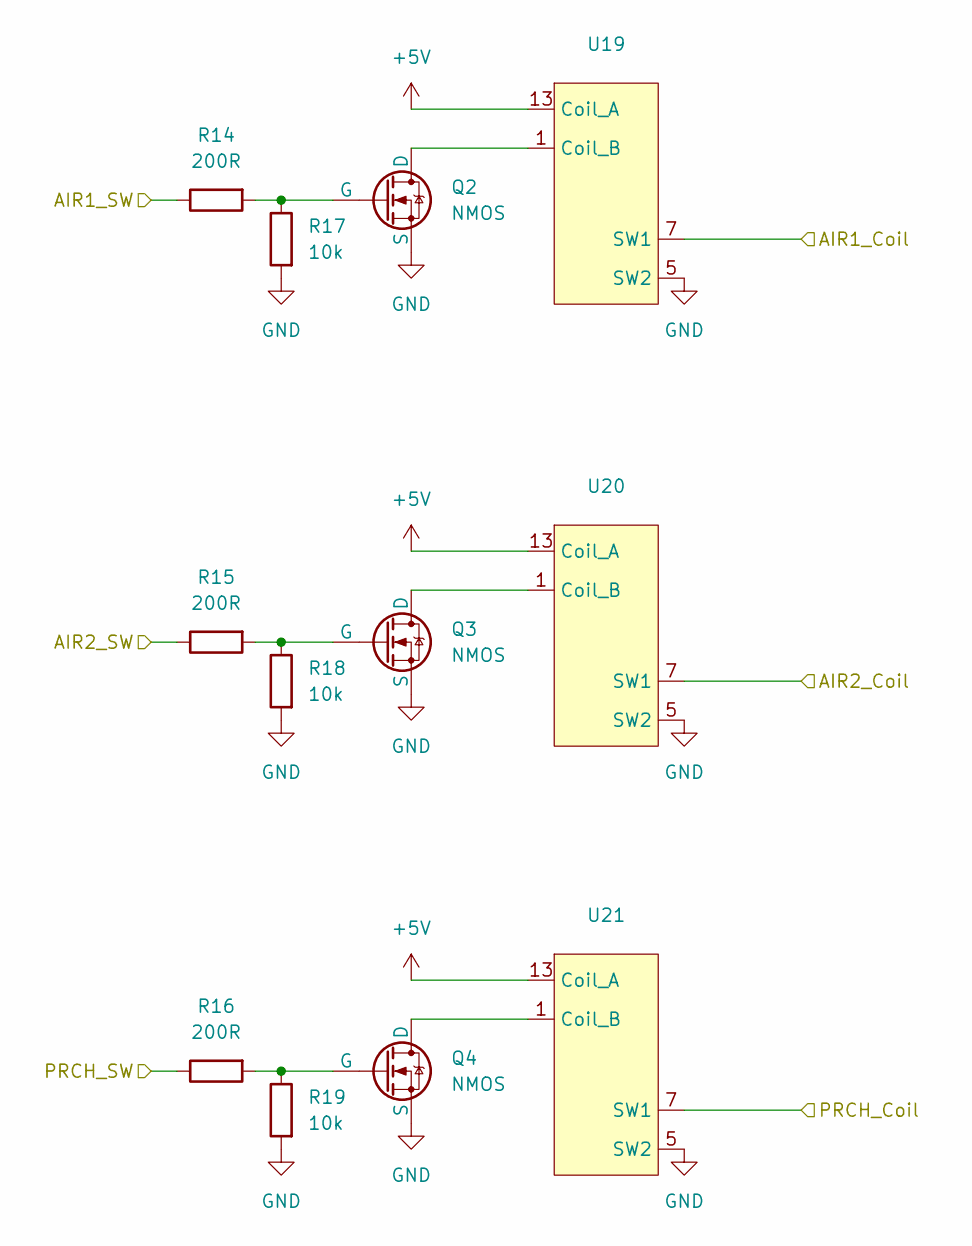
[picture p22: schematic AIR_switch.kicad_sch, TSAL]

Parts:
Q2, Q3, Q4: NMOS; SOT-23-3; Mouser 726-BSS316NH6327
R14, R15, R16: 200R; R_0603_1608Metric
R17, R18, R19: 10k; R_0603_1608Metric
U19, U20, U21: AZ9371

Connections:
+5V: U19.13 (Coil_A), U20.13 (Coil_A), U21.13 (Coil_A); also elsewhere on the board
/AIR Switch/AIR1_Coil: U19.7 (SW1); also elsewhere on the board
/AIR Switch/AIR1_SW: R14.1; also elsewhere on the board
/AIR Switch/AIR2_Coil: U20.7 (SW1); also elsewhere on the board
/AIR Switch/AIR2_SW: R15.1; also elsewhere on the board
/AIR Switch/PRCH_Coil: U21.7 (SW1); also elsewhere on the board
/AIR Switch/PRCH_SW: R16.1; also elsewhere on the board
GND: Q2.3 (S), Q3.3 (S), Q4.3 (S), R17.2, R18.2, R19.2, U19.5 (SW2), U20.5 (SW2), U21.5 (SW2); also elsewhere on the board
unnamed: Q2.1 (D), U19.1 (Coil_B)
unnamed: Q2.2 (G), R14.2, R17.1
unnamed: Q3.1 (D), U20.1 (Coil_B)
unnamed: Q3.2 (G), R15.2, R18.1
unnamed: Q4.1 (D), U21.1 (Coil_B)
unnamed: Q4.2 (G), R16.2, R19.1

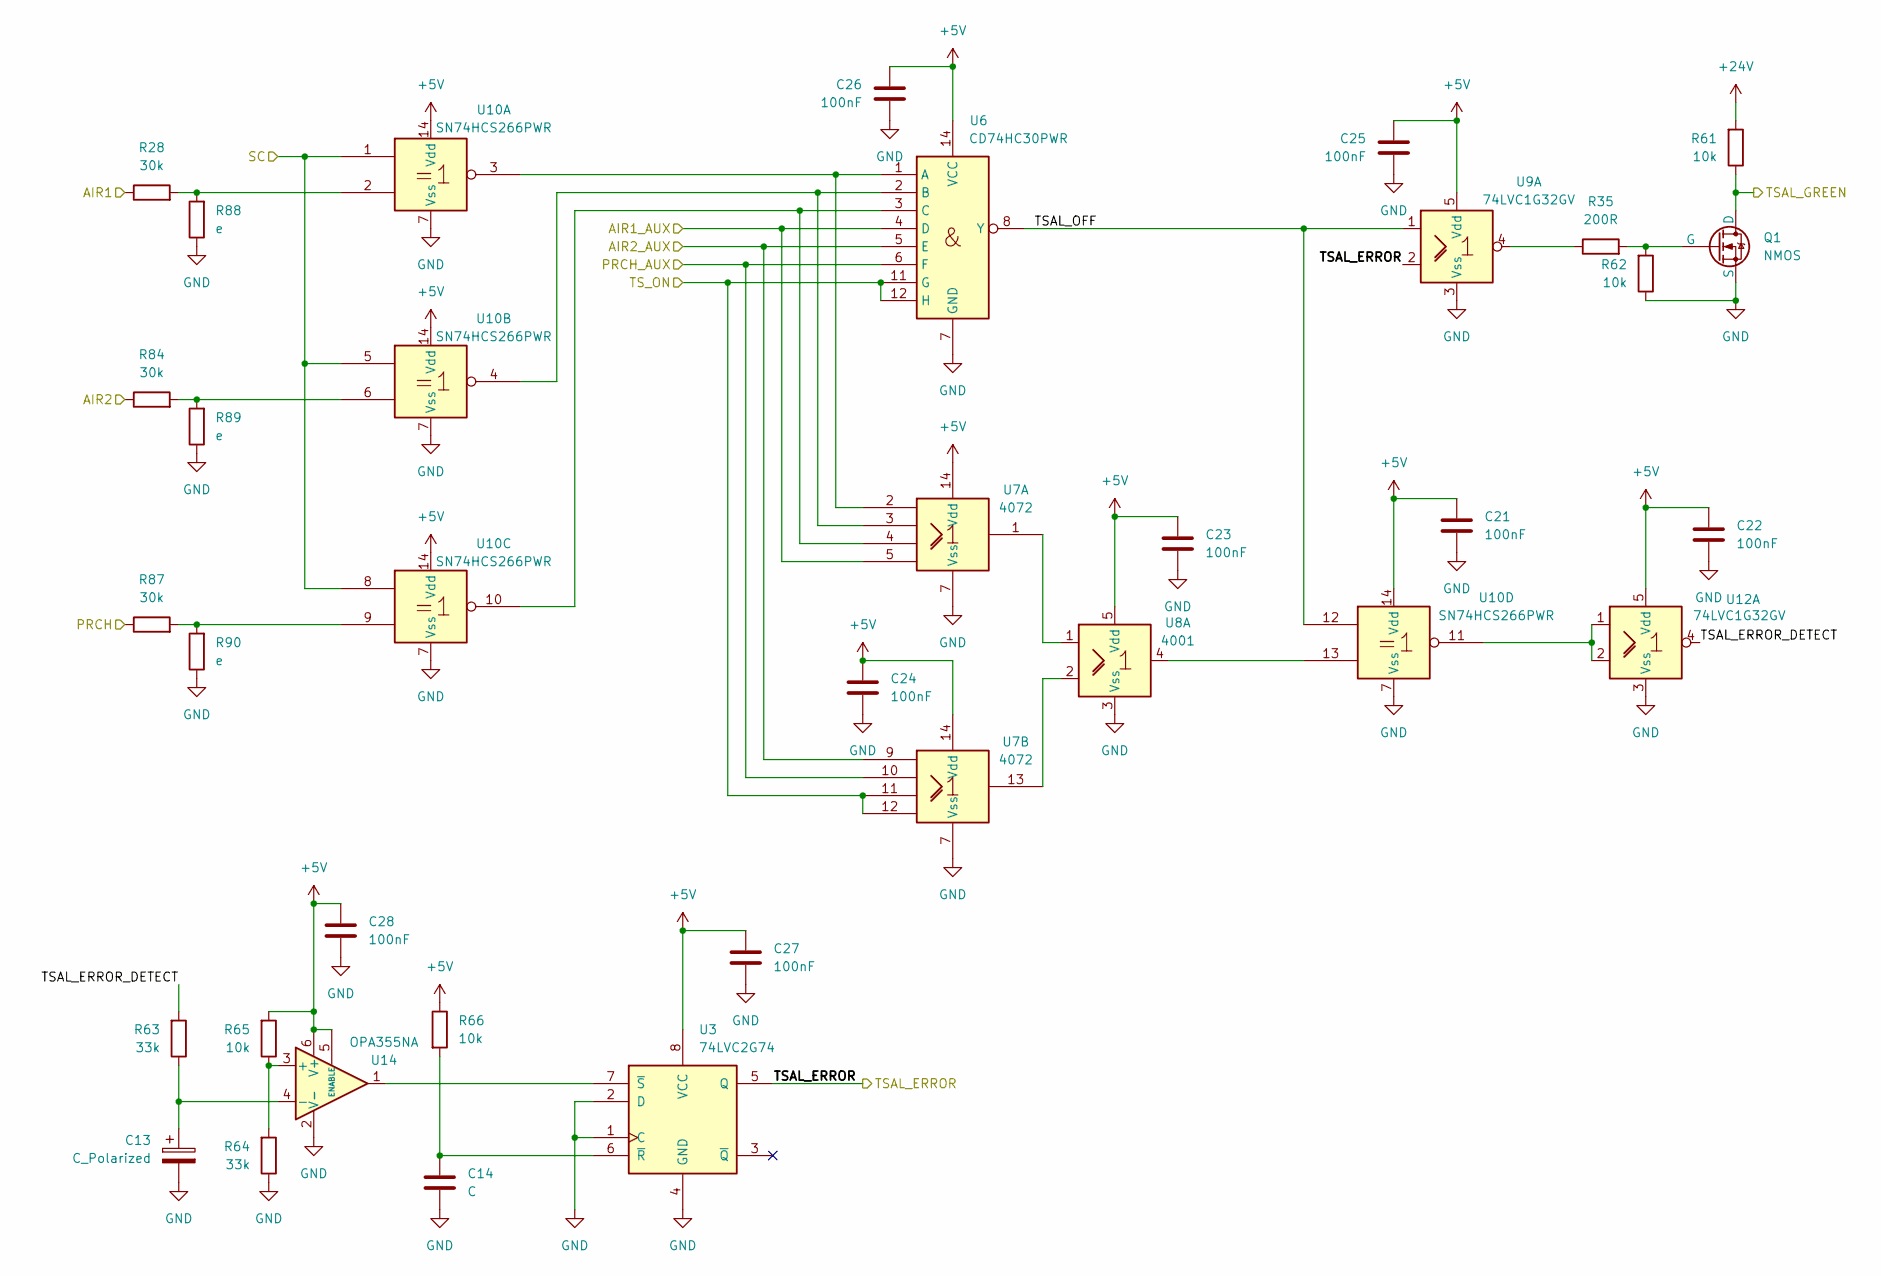
[picture p23: schematic TSAL_plausibility.kicad_sch, TSAL]

Parts:
C13: C_Polarized; C_0603_1608Metric
C14: C; C_0603_1608Metric
C21, C22, C23, C24, C25, C26, C27, C28: 100nF; C_0603_1608Metric
Q1: NMOS; SOT-23-3; Mouser 726-BSS316NH6327
R28, R84, R87: 30k; R_0603_1608Metric
R35: 200R; R_0603_1608Metric
R61, R62, R65, R66: 10k; R_0603_1608Metric
R63, R64: 33k; R_0603_1608Metric
R88, R89, R90: e; R_0603_1608Metric
U3: 74LVC2G74; TSSOP-8_3x3mm_P0.65mm; Mouser 771-74LVC2G74DP-G
U6: CD74HC30PWR; TSSOP-14_4.4x5mm_P0.65mm; Mouser 595-CD74HC30PWR
U7: 4072; TSSOP-14_4.4x5mm_P0.65mm; Mouser 595-CD4072BPW
U8: 4001; SC-74A-5_1.55x2.9mm_P0.95mm; Mouser 771-LVC1G32GV125
U9, U12: 74LVC1G32GV; SC-74A-5_1.55x2.9mm_P0.95mm; Mouser 771-LVC1G32GV125
U10: SN74HCS266PWR; TSSOP-14_4.4x5mm_P0.65mm; Mouser 595-SN74HCS266PWR
U14: OPA355NA; SOT-23-6; Mouser 595-OPA355NA/3K

Connections:
+5V: C21.1, C22.1, C23.1, C24.1, C25.1, C26.1, C27.1, C28.1, R65.2, R66.1, U3.8 (VCC), U6.14 (VCC), U7.14 (Vdd), U8.5 (Vdd), U9.5 (Vdd), U10.14 (Vdd), U12.5 (Vdd), U14.5 (ENABLE), U14.6 (V+); also elsewhere on the board
+24V: R61.2; also elsewhere on the board
/AIR Switch/AIR1_Coil: R28.1; also elsewhere on the board
/AIR Switch/AIR2_Coil: R84.1; also elsewhere on the board
/AIR Switch/PRCH_Coil: R87.1; also elsewhere on the board
/LV Connectors/AIR1_AUX: U6.4 (D), U7.5; also elsewhere on the board
/LV Connectors/AIR2_AUX: U6.5 (E), U7.9; also elsewhere on the board
/LV Connectors/PRCH_AUX: U6.6 (F), U7.10; also elsewhere on the board
/LV Connectors/SC: U10.1, U10.5, U10.8; also elsewhere on the board
/LV Connectors/TSAL_LED_GREEN: Q1.1 (D), R61.1; also elsewhere on the board
/LV Connectors/TS_ON: U6.11 (G), U6.12 (H), U7.11, U7.12; also elsewhere on the board
/TSAL Plausibility/TSAL_ERROR: U3.5 (Q), U9.2; also elsewhere on the board
/TSAL Plausibility/TSAL_ERROR_DETECT: R63.2, U12.4
/TSAL Plausibility/TSAL_OFF: U6.8 (Y), U9.1, U10.12
GND: C13.2, C14.2, C21.2, C22.2, C23.2, C24.2, C25.2, C26.2, C27.2, C28.2, Q1.3 (S), R62.1, R64.1, R88.1, R89.1, R90.1, U3.1 (C), U3.2 (D), U3.4 (GND), U6.7 (GND), U7.7 (Vss), U8.3 (Vss), U9.3 (Vss), U10.7 (Vss), U12.3 (Vss), U14.2 (V-); also elsewhere on the board
unnamed: Q1.2 (G), R35.2, R62.2
unnamed: R28.2, R88.2, U10.2
unnamed: R35.1, U9.4
unnamed: R84.2, R89.2, U10.6
unnamed: R87.2, R90.2, U10.9
unnamed: C14.1, R66.2, U3.6 (~R)
unnamed: U3.7 (~S), U14.1
unnamed: U6.1 (A), U7.2, U10.3
unnamed: U6.2 (B), U7.3, U10.4
unnamed: U6.3 (C), U7.4, U10.10
unnamed: U7.1, U8.1
unnamed: U7.13, U8.2
unnamed: U10.11, U12.1, U12.2
unnamed: U8.4, U10.13
unnamed: R64.2, R65.1, U14.3 (+)
unnamed: C13.1, R63.1, U14.4 (-)

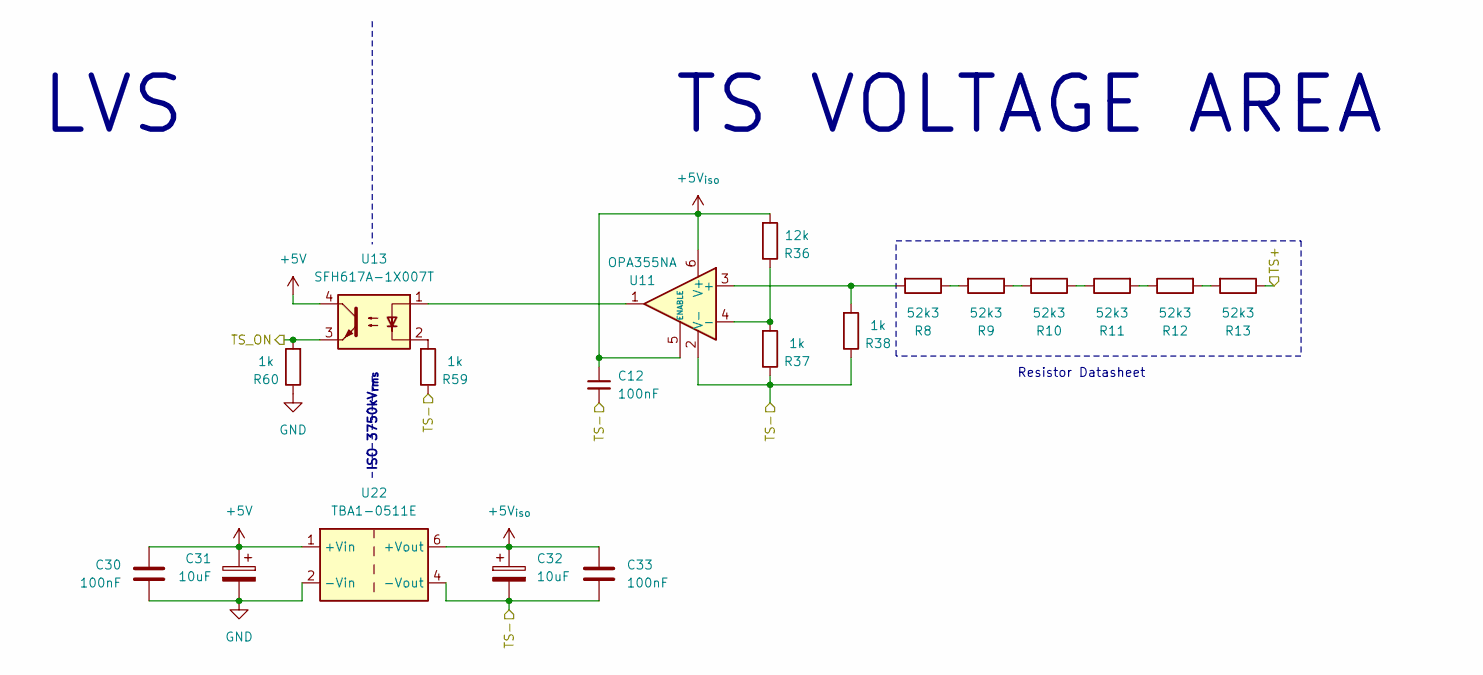
[picture p24: schematic TS_sense.kicad_sch, TSAL]

Parts:
C12, C30, C33: 100nF; C_0603_1608Metric
C31, C32: 10uF; C_0603_1608Metric
R8, R9, R10, R11, R12, R13: 52k3; R_0805_2012Metric; Mouser 603-RT0805DRD0752K3L
R36: 12k; R_0603_1608Metric
R37, R38, R59, R60: 1k; R_0603_1608Metric
U11: OPA355NA; SOT-23-6; Mouser 595-OPA355NA/3K
U13: SFH617A-1X007T; SMDIP-4_W9.53mm_Clearance8mm; Mouser 710-140357145300
U22: TBA1-0511E; Converter_DCDC_TRACO_TBA1-xxxxE_Single_THT; Mouser 495-TBA1-0511E

Connections:
+5V: C30.1, C31.1, U13.4, U22.1 (+Vin); also elsewhere on the board
+5V_{iso}: C12.1, C32.1, C33.1, R36.2, U11.5 (ENABLE), U11.6 (V+), U22.6 (+Vout)
/LV Connectors/TS_ON: R60.2, U13.3; also elsewhere on the board
GND: C30.2, C31.2, R60.1, U22.2 (-Vin); also elsewhere on the board
HV+: R13.1; also elsewhere on the board
HV-: C12.2, C32.2, C33.2, R37.1, R38.1, R59.1, U11.2 (V-), U22.4 (-Vout); also elsewhere on the board
unnamed: R8.1, R9.2
unnamed: R10.1, R11.1
unnamed: R9.1, R10.2
unnamed: R11.2, R12.1
unnamed: R12.2, R13.2
unnamed: R59.2, U13.2
unnamed: R8.2, R38.2, U11.3 (+)
unnamed: R36.1, R37.2, U11.4 (-)
unnamed: U11.1, U13.1

Notes on the sheet:
TS VOLTAGE AREA
ISO 3750kV_{rms}
LVS
Resistor Datasheet

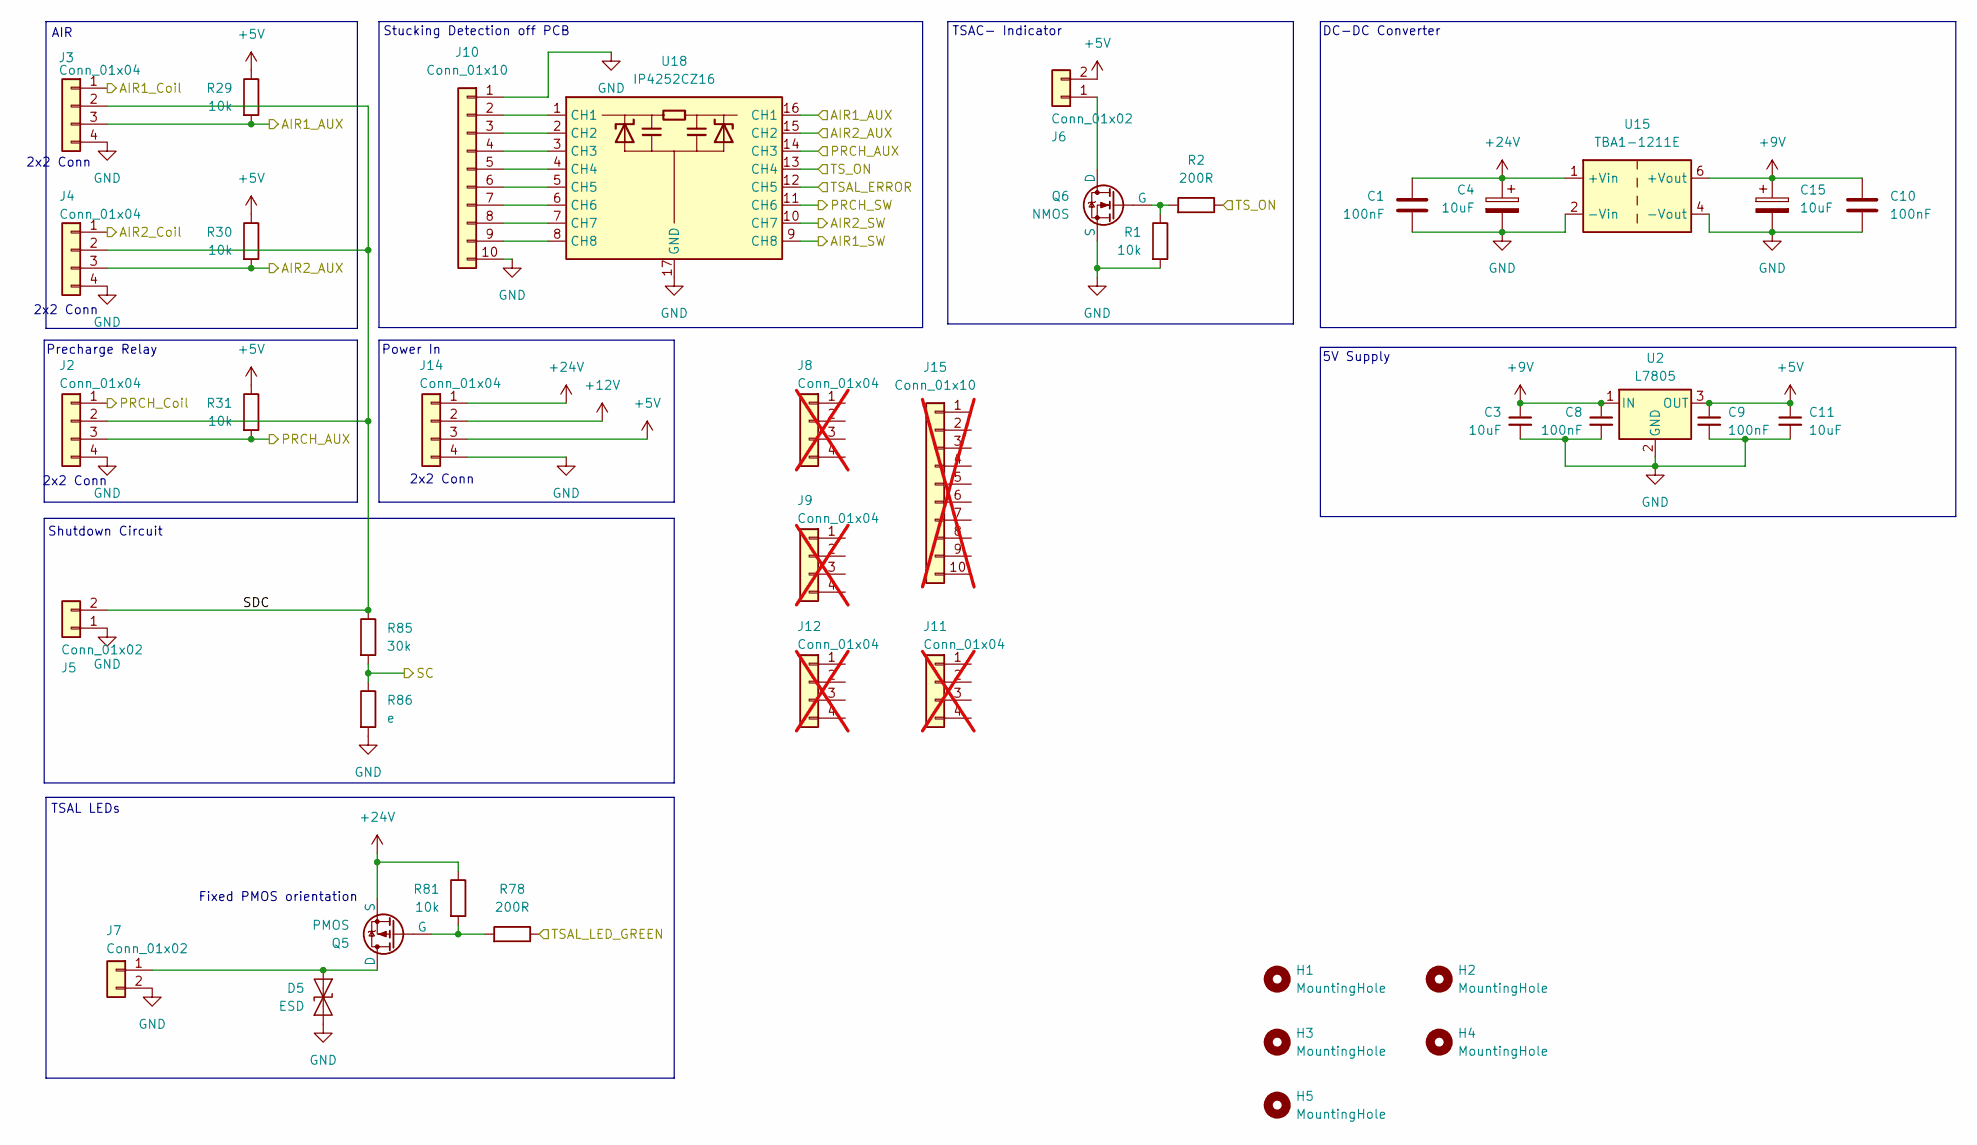
[picture p25: schematic lv_connectors.kicad_sch, TSAL]

Parts:
C1, C8, C9, C10: 100nF; C_0603_1608Metric
C3, C4, C11, C15: 10uF; C_0603_1608Metric
D5: ESD; Infineon_SG-WLL-2-3_0.58x0.28_P0.36mm; Mouser 726-ESD131B1W0201E63
H1, H2, H3, H4, H5: MountingHole; MountingHole_3.2mm_M3
J2, J3, J4, J14: Conn_01x04; 66200421022; Mouser 710-66200421022
J5, J7: Conn_01x02; 66200211024
J6: Conn_01x02; JST_XH_B2B-XH-A_1x02_P2.50mm_Vertical
J8, J9, J11, J12: Conn_01x04; Mouser 710-662004113322; not fitted
J10: Conn_01x10; IDC-Header_2x05_P2.54mm_Latch6.5mm_Vertical; Mouser 710-61201022021
J15: Conn_01x10; Mouser 710-61201023021; not fitted
Q5: PMOS; SOT-23-3
Q6: NMOS; SOT-23-3; Mouser 726-BSS316NH6327
R1, R29, R30, R31, R81: 10k; R_0603_1608Metric
R2, R78: 200R; R_0603_1608Metric
R85: 30k; R_0603_1608Metric
R86: e; R_0603_1608Metric
U2: L7805; TO-252-2; Mouser 511-L7805ABD2T-TR
U15: TBA1-1211E; Converter_DCDC_TRACO_TBA1-xxxxE_Single_THT; Mouser 495-TBA1-1219HI
U18: IP4252CZ16; Nexperia_HUSON-16_USON-16-1EP_1.35x3.3mm_P0.4mm_EP0.4x2.8mm; Mouser 771-IP4252CZ168TTL1

Connections:
+5V: C9.1, C11.1, J6.2, J14.3, R29.1, R30.1, R31.1, U2.3 (OUT); also elsewhere on the board
+9V: C3.1, C8.1, C10.1, C15.1, U2.1 (IN), U15.6 (+Vout)
+12V: J14.2
+24V: C1.1, C4.1, J14.1, Q5.3 (S), R81.1, U15.1 (+Vin); also elsewhere on the board
/AIR Switch/AIR1_Coil: J3.1; also elsewhere on the board
/AIR Switch/AIR1_SW: U18.9 (CH8); also elsewhere on the board
/AIR Switch/AIR2_Coil: J4.1; also elsewhere on the board
/AIR Switch/AIR2_SW: U18.10 (CH7); also elsewhere on the board
/AIR Switch/PRCH_Coil: J2.1; also elsewhere on the board
/AIR Switch/PRCH_SW: U18.11 (CH6); also elsewhere on the board
/LV Connectors/AIR1_AUX: J3.3, R29.2, U18.16 (CH1); also elsewhere on the board
/LV Connectors/AIR2_AUX: J4.3, R30.2, U18.15 (CH2); also elsewhere on the board
/LV Connectors/PRCH_AUX: J2.3, R31.2, U18.14 (CH3); also elsewhere on the board
/LV Connectors/SC: R85.2, R86.1; also elsewhere on the board
/LV Connectors/SDC: J2.2, J3.2, J4.2, J5.2, R85.1
/LV Connectors/TSAL_LED_GREEN: R78.1; also elsewhere on the board
/LV Connectors/TS_ON: R2.1, U18.13 (CH4); also elsewhere on the board
/TSAL Plausibility/TSAL_ERROR: U18.12 (CH5); also elsewhere on the board
GND: C1.2, C3.2, C4.2, C8.2, C9.2, C10.2, C11.2, C15.2, D5.1 (A1), J2.4, J3.4, J4.4, J5.1, J7.2, J10.1, J10.10, J14.4, Q6.3 (S), R1.2, R86.2, U2.2 (GND), U15.2 (-Vin), U15.4 (-Vout), U18.17 (GND); also elsewhere on the board
unnamed: D5.2 (A2), J7.1, Q5.1 (D)
unnamed: J6.1, Q6.1 (D)
unnamed: J10.2, U18.1 (CH1)
unnamed: J10.3, U18.2 (CH2)
unnamed: J10.4, U18.3 (CH3)
unnamed: J10.5, U18.4 (CH4)
unnamed: J10.6, U18.5 (CH5)
unnamed: J10.7, U18.6 (CH6)
unnamed: J10.8, U18.7 (CH7)
unnamed: J10.9, U18.8 (CH8)
unnamed: Q5.2 (G), R78.2, R81.2
unnamed: Q6.2 (G), R1.1, R2.2

Notes on the sheet:
2x2 Conn
DC-DC Converter
Power In
Stucking Detection off PCB
TSAC- Indicator
TSAL LEDs
5V Supply
Shutdown Circuit
AIR
Precharge Relay
Fixed PMOS orientation

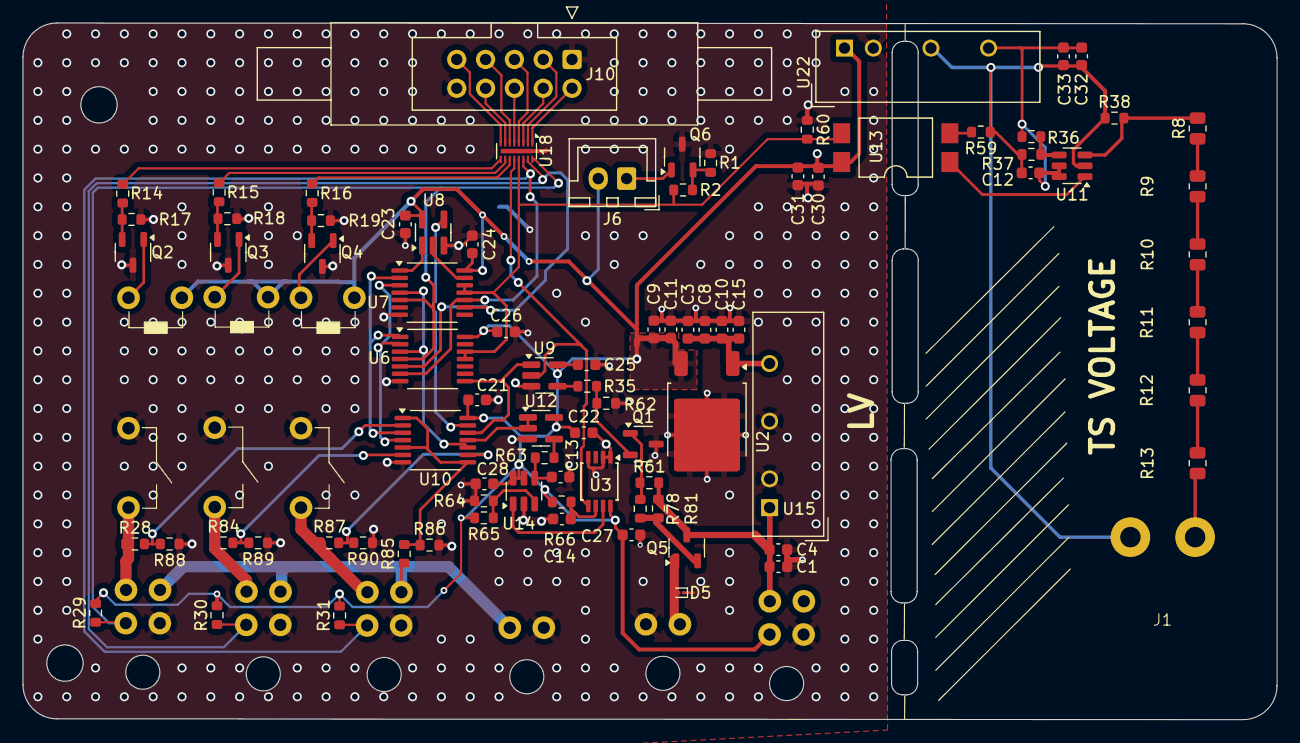
[picture p26: board rpm_TSAL.kicad_pcb from above]

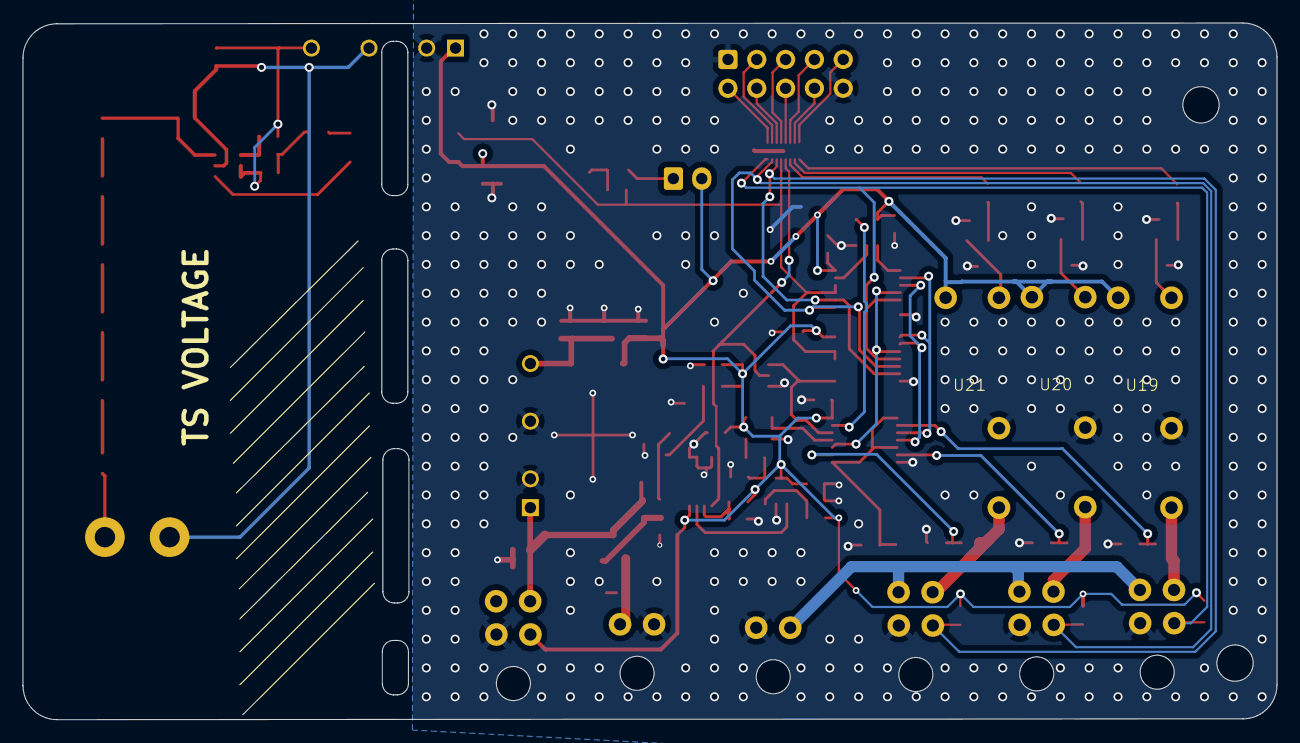
[picture p27: board rpm_TSAL.kicad_pcb from below]

Board: 2 copper layers, 110.5 x 61.4 mm, 100 parts (3 on the bottom side), 66 nets.
