aculleon/rpm_TSAL/rpm_TSAL_RED/rpm_TSAL_RED.kicad_pcb

## KiCad design rpm_TSAL_RED/rpm_TSAL_RED.kicad_pcb (2024-07-26)

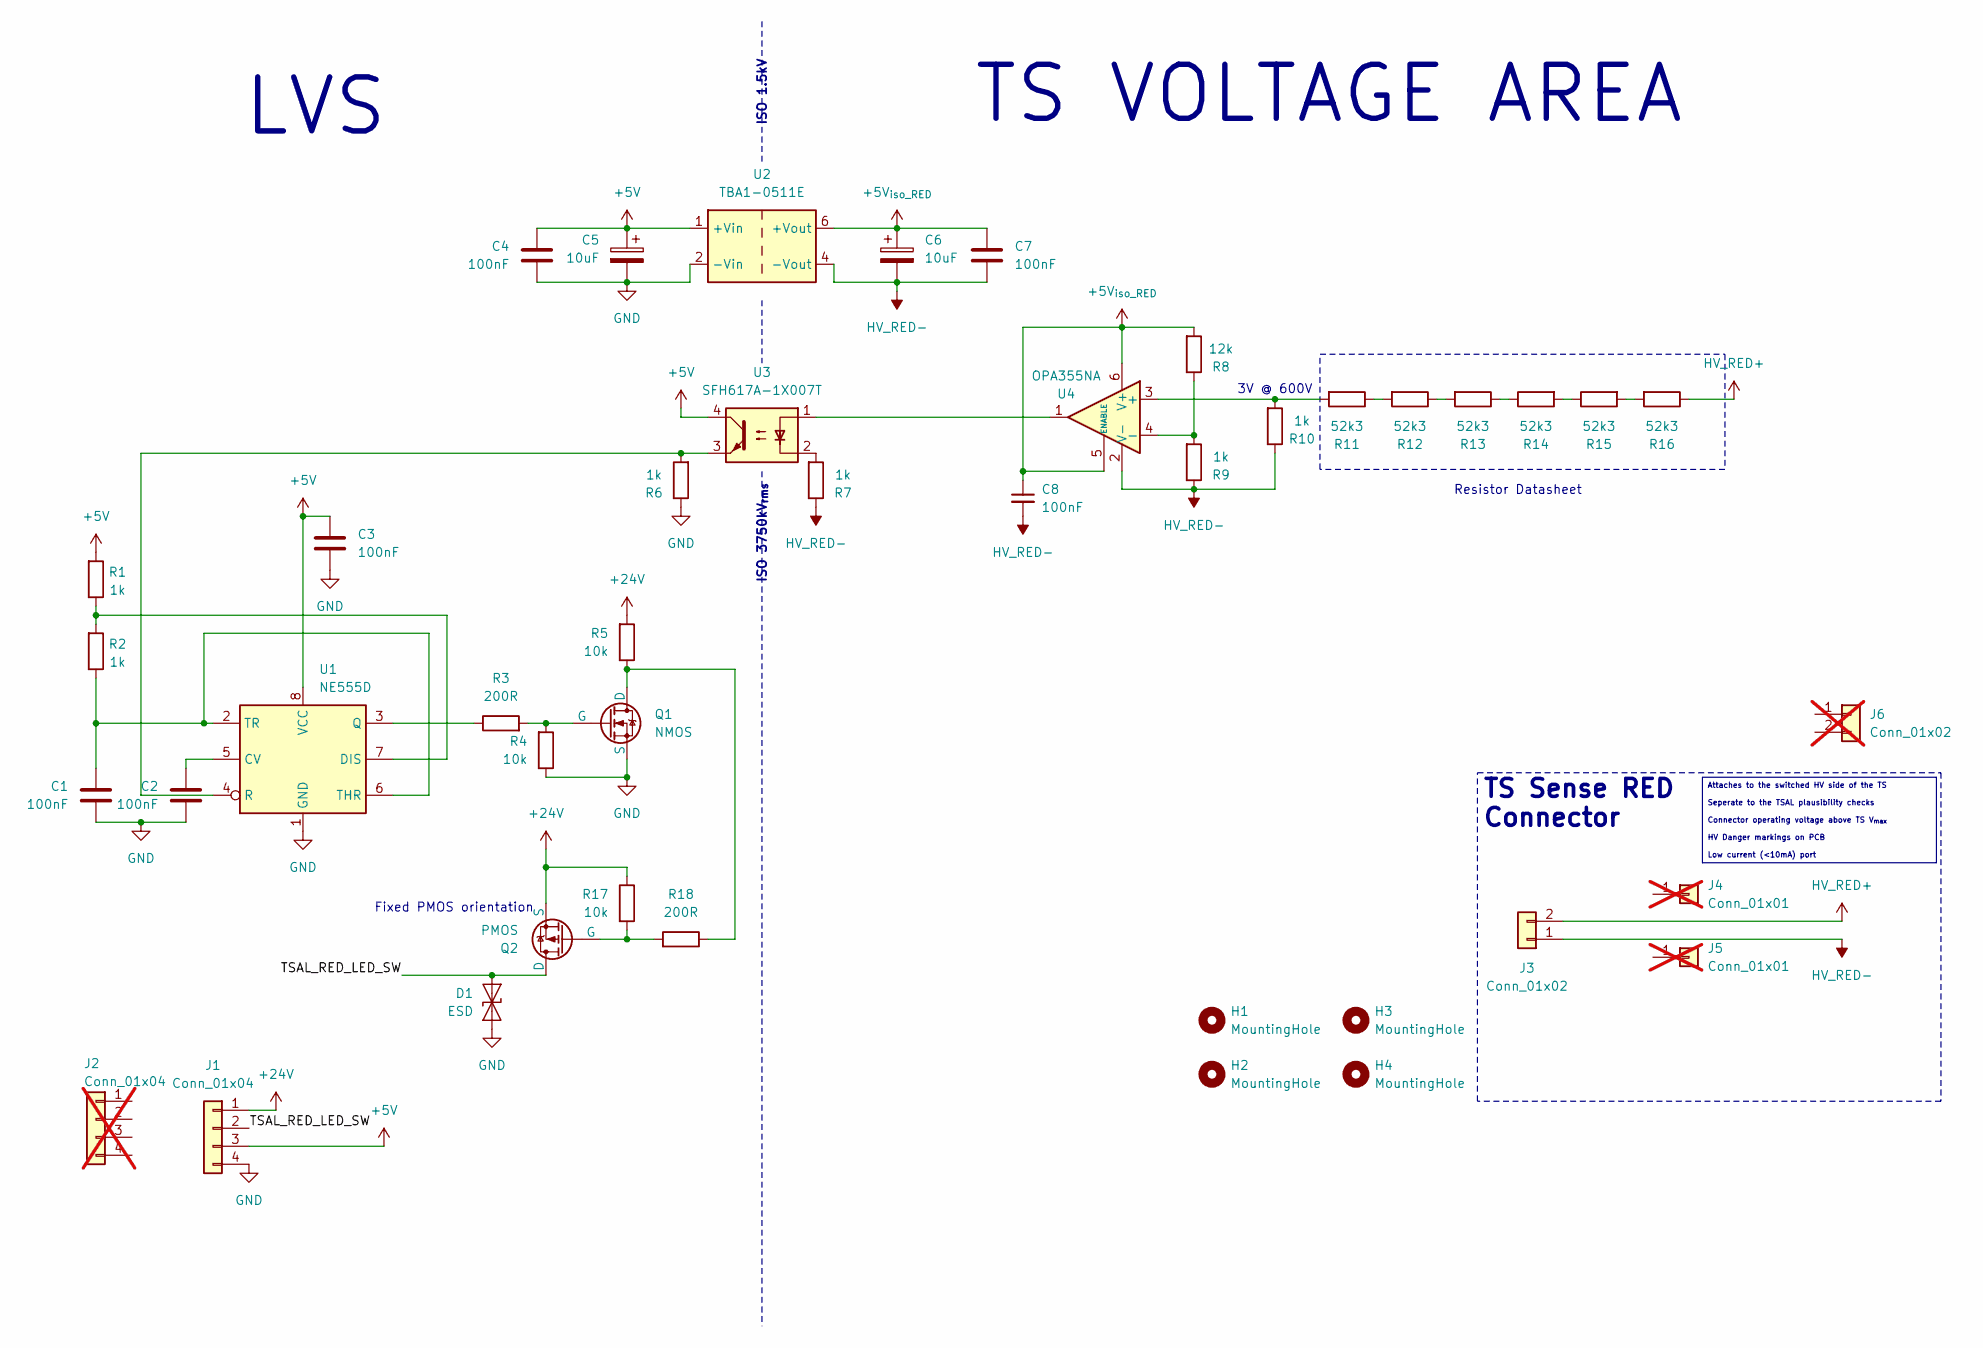
[picture p28: schematic rpm_TSAL_RED.kicad_sch, RED TSAL Control]

Parts:
C1, C2, C3, C4, C7, C8: 100nF; C_0603_1608Metric
C5, C6: 10uF; C_0603_1608Metric
D1: ESD; Infineon_SG-WLL-2-3_0.58x0.28_P0.36mm; Mouser 726-ESD131B1W0201E63
H1, H2, H3, H4: MountingHole; MountingHole_3.2mm_M3_DIN965
J1: Conn_01x04; 66200411022; Mouser 710-66200421022
J2: Conn_01x04; Mouser 710-662004113322; not fitted
J3: Conn_01x02; 657002130101; Mouser 710-657002130101
J4, J5: Conn_01x01; Mouser 710-65730513722DEC; not fitted
J6: Conn_01x02; Mouser 710-657002150201; not fitted
Q1: NMOS; SOT-23-3; Mouser 726-BSS316NH6327
Q2: PMOS; SOT-23-3
R1, R2, R6, R7, R9, R10: 1k; R_0603_1608Metric
R3, R18: 200R; R_0603_1608Metric
R4, R5, R17: 10k; R_0603_1608Metric
R8: 12k; R_0603_1608Metric
R11, R12, R13, R14, R15, R16: 52k3; R_0805_2012Metric; Mouser 603-RT0805DRD0752K3L
U1: NE555D; SOIC-8_3.9x4.9mm_P1.27mm; Mouser 595-NE555DR
U2: TBA1-0511E; Converter_DCDC_TRACO_TBA1-xxxxE_Single_THT; Mouser 495-TBA1-0511E
U3: SFH617A-1X007T; SMDIP-4_W9.53mm_Clearance8mm; Mouser 710-140357145300
U4: OPA355NA; SOT-23-6; Mouser 595-OPA355NA/3K

Connections:
+5V: C3.1, C4.1, C5.1, J1.3, R1.2, U1.8 (VCC), U2.1 (+Vin), U3.4
+5V_{iso_RED}: C6.1, C7.1, C8.1, R8.2, U2.6 (+Vout), U4.5 (ENABLE), U4.6 (V+)
+24V: J1.1, Q2.3 (S), R5.2, R17.1
/TSAL_RED_LED_SW: D1.2 (A2), J1.2, Q2.1 (D)
GND: C1.2, C2.2, C3.2, C4.2, C5.2, D1.1 (A1), J1.4, Q1.3 (S), R4.1, R6.1, U1.1 (GND), U2.2 (-Vin)
HV_RED+: J3.2, R16.1
HV_RED-: C6.2, C7.2, C8.2, J3.1, R7.1, R9.1, R10.1, U2.4 (-Vout), U4.2 (V-)
unnamed: Q1.1 (D), R5.1, R18.1
unnamed: Q1.2 (G), R3.2, R4.2
unnamed: Q2.2 (G), R17.2, R18.2
unnamed: R7.2, U3.2
unnamed: R11.1, R12.2
unnamed: R12.1, R13.2
unnamed: R13.1, R14.1
unnamed: R14.2, R15.1
unnamed: R15.2, R16.2
unnamed: C2.1, U1.5 (CV)
unnamed: R1.1, R2.2, U1.7 (DIS)
unnamed: R3.1, U1.3 (Q)
unnamed: R6.2, U1.4 (R), U3.3
unnamed: C1.1, R2.1, U1.2 (TR), U1.6 (THR)
unnamed: U3.1, U4.1
unnamed: R10.2, R11.2, U4.3 (+)
unnamed: R8.1, R9.2, U4.4 (-)

Notes on the sheet:
Attaches to the switched HV side of the TS Seperate to the TSAL plausibility checks Connector operating voltage above TS V_{max} HV Danger markings on PCB Low current (<10mA) port
Fixed PMOS orientation
TS VOLTAGE AREA
ISO 3750kV_{rms}
3V @ 600V
TS Sense RED Connector
Resistor Datasheet
ISO 1.5kV
LVS

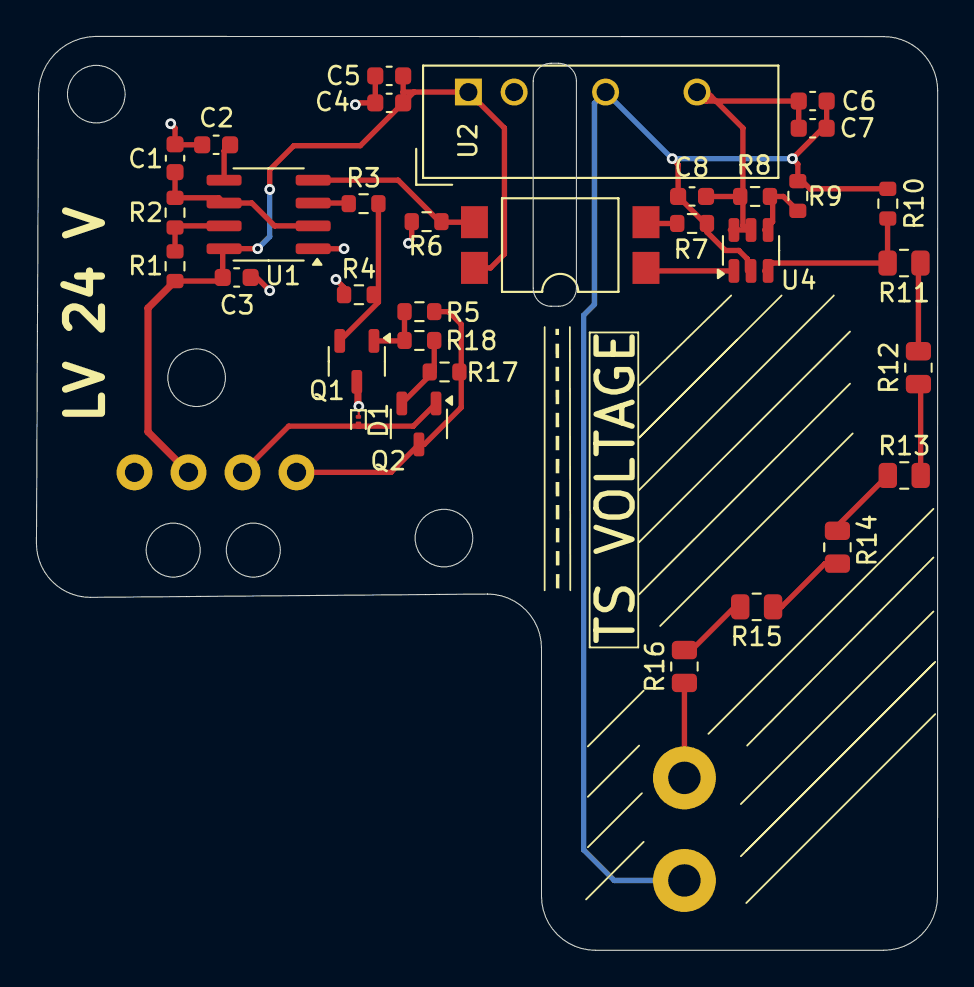
[picture p29: board rpm_TSAL_RED.kicad_pcb from above]

Board: 2 copper layers, 50.1 x 50.8 mm, 39 parts (0 on the bottom side), 24 nets.
