aculleon/rpm_TSAL/(commit log)

2024-07-11 Saved. Initial Structure done.
    [TSAL_plausibility.kicad_sch, TSAL_red.kicad_sch, lv_connectors.kicad_sch, rpm_TSAL.kicad_pcb]
2024-07-11 added OPA and HV Resistors
    [TSAL_red.kicad_sch, rpm_TSAL.kicad_sch]
2024-07-11 Added *.lck to gitignore
    [TSAL_red.kicad_sch]
2024-07-14 Changes to Pinout pending
    [TSAL_plausibility.kicad_sch, TSAL_red.kicad_sch, lv_connectors.kicad_sch, rpm_TSAL.kicad_pcb, rpm_TSAL.kicad_sch]
2024-07-15 Changed Layout
    [TSAL_red.kicad_sch, TS_sense.kicad_sch, rpm_TSAL.kicad_sch]
2024-07-15 Checked Rules. Looks good. Need to fix AIR Aux detection. Need to Fix Coil Activation. Need to add SCS Failure Output and SCS Failure Inhibiter
    [TSAL_plausibility.kicad_sch, lv_connectors.kicad_sch, rpm_TSAL.kicad_pcb, rpm_TSAL.kicad_sch]
2024-07-15 Added new Subsheet
    [SCS_integrity_check.kicad_sch, lv_connectors.kicad_sch, rpm_TSAL.kicad_sch]
2024-07-15 Added decoupling Caps
    [SCS_integrity_check.kicad_sch, TSAL_plausibility.kicad_sch, TSAL_red.kicad_sch, TS_sense.kicad_sch, lv_connectors.kicad_sch, rpm_TSAL.kicad_sch]
2024-07-15 Added Rules
    [TSAL_plausibility.kicad_sch, TSAL_red.kicad_sch, TS_sense.kicad_sch, lv_connectors.kicad_sch, rpm_TSAL.kicad_sch]
2024-07-15 Submission Ready. ESF 15.07.24
    [TSAL_plausibility.kicad_sch, TSAL_red.kicad_sch, TS_sense.kicad_sch, lv_connectors.kicad_sch, rpm_TSAL.kicad_sch]
2024-07-15 Added Subschematic
    [AIR_switch.kicad_sch]
2024-07-16 TS Detection routing
    [rpm_TSAL.kicad_pcb]
2024-07-22 TSAL Rev 0.2
    [AIR_switch.kicad_sch, TSAL_plausibility.kicad_sch, TSAL_red.kicad_sch, TS_sense.kicad_sch, lv_connectors.kicad_sch, rpm_TSAL.kicad_pcb, rpm_TSAL.kicad_sch]
2024-07-23 Added Seperate Project
    [TSAL_red.kicad_sch, lv_connectors.kicad_sch, rpm_TSAL.kicad_pcb, rpm_TSAL.kicad_sch, rpm_TSAL_RED.kicad_pcb, rpm_TSAL_RED.kicad_sch]
2024-07-24 Added Sub project
    [61201022021 (rev1).stp, 66200211024_STP (rev1).stp, 66200311022 (rev1).stp, 66200411022 (rev1).stp, 66201421022 (rev1).stp, AIR_switch.kicad_sch, AZ9371-1A-12D.stp, STP_MPC5_657002130101 (rev1).stp]
2024-07-24 Connector Updated
    [66200421022 (rev1).stp, lv_connectors.kicad_sch, rpm_TSAL.kicad_pcb]
2024-07-24 Routing of AIR Relay
    [lv_connectors.kicad_sch, rpm_TSAL.kicad_pcb]
2024-07-26 Added TSAC Indicator with PSU
    [TSAL_plausibility.kicad_sch, TS_sense.kicad_sch, lv_connectors.kicad_sch, rpm_TSAL.kicad_pcb, rpm_TSAL.kicad_sch, rpm_TSAL_RED.kicad_pcb]
2024-07-26 Added ESF comments
    [TSAC.kicad_sch]
